ryanmio/legend-class-autonomous-cutter/firmware/legend_cutter/telemetry.cpp

// telemetry.cpp
// WiFi (scan-first: home → any "iPhone" hotspot → blind fallback; no AP) +
// non-blocking in-loop reconnect, plus the HTTP server with the full
// /telemetry JSON and all command endpoints. Wire contract mirrors the PASS'd
// test_29 build 1:1 (key set, key order, routes) — the phone app is firmware-
// agnostic only as long as that holds.

#include "telemetry.h"
#include "config.h"
#include "secrets.h"
#include "ibus.h"
#include "motors.h"
#include "imu.h"
#include "gps.h"
#include "navigation.h"
#include "battery.h"
#include "bilge.h"
#include "sonar.h"
#include "audio.h"
#include "radar.h"
#include "lights.h"
#include "lowvolt.h"
#include "floodalarm.h"
#include "weapons.h"
#include "histlog.h"
#include "flightlog.h"
#include "cmd.h"

#include <WiFi.h>
#include <WebServer.h>
#include <ArduinoJson.h>
#include <esp_system.h>
#include <esp_wifi.h>

// Provided by legend_cutter.ino — current vessel mode label + failsafe ack.
extern const char* vesselModeName();
extern bool        vesselFailsafeAck();

static WebServer    server(HTTP_PORT);
static void         networkTask(void*);    // core-0 task; owns handleClient()/wifiMaintain()
static TaskHandle_t netTaskHandle = NULL;  // for stack high-water queries from the loop console
static String       boatIP;
static uint16_t  cruiseUs  = DEFAULT_CRUISE_US;
static uint32_t  sessionId = 0;     // hardware-random, set once in telemetryBegin()

// WiFi link state, published by networkTask (core 0) ~2 Hz and read cross-core
// by histlogUpdate (core 1). Lock-free, expendable — same discipline as the
// telemetry reads, so the control loop never touches a network function.
static volatile bool   wifiAssocPub = false;
static volatile int8_t wifiRssiPub  = 0;    // dBm when associated, else 0

// millis() of the last app request, written by the core-0 handlers and read
// cross-core by histlog (core 1). Lock-free, expendable — same discipline as
// the WiFi publishes above.
static volatile uint32_t lastClientMs = 0;

// Lazily generated so flightlogBegin() (which runs before telemetryBegin())
// can stamp the boot's session into the flight-file header; telemetryBegin()
// calls this too, so both always see the same value.
uint32_t telemetrySessionId() {
    while (sessionId == 0) sessionId = esp_random();
    return sessionId;
}

uint16_t    telemetryCruiseUs()             { return cruiseUs; }
void        telemetrySetCruiseUs(uint16_t us) { cruiseUs = us; }  // control loop only (cmdApply)
const char* telemetryBoatIP()               { return boatIP.c_str(); }
bool        telemetryWifiAssoc()            { return wifiAssocPub; }
int8_t      telemetryWifiRssiDbm()          { return wifiRssiPub; }
uint32_t    telemetryLastClientMs()         { return lastClientMs; }

// Network task's worst-case-ever free stack (bytes). Queried from the loop's
// serial console; uxTaskGetStackHighWaterMark works cross-task given the handle.
uint32_t    telemetryNetStackFreeBytes() {
    return netTaskHandle ? (uint32_t)(uxTaskGetStackHighWaterMark(netTaskHandle) * sizeof(StackType_t)) : 0;
}

// ── WiFi (scan-first connect + non-blocking maintain, ported from test_29) ──
static String lastSsid;
static String lastPass;
static bool   wifiWasConnected = false;

// Boot-time nav-light signal so the operator can read WiFi state across the
// pool: 1 flash when scanning starts, 2 flashes once connected. Setup-only
// (boat neutral on the bench); leaves the LED off afterward.
static void blinkNav(int times) {
    for (int i = 0; i < times; i++) {
        digitalWrite(PIN_NAV, HIGH); delay(120);
        digitalWrite(PIN_NAV, LOW);  delay(120);
    }
}

// STA-link range/robustness tuning. Telemetry/command only — does NOT touch the
// RC/iBUS control path or the FSM. Split in two: the protocol/bandwidth pins must
// be set on the started driver before associating; the power-save + TX-power
// asserts are re-applied on every (re)connect because association can reset them.
//
// 11b is kept enabled so rate control retains the longest-range basic-rate
// fallback; 20 MHz is pinned for edge robustness. Channel is the AP's to choose
// (a STA follows it), so it's a router-side setting, not a firmware lever.
static void wifiSetStaRadioConfig() {
    esp_wifi_set_protocol(WIFI_IF_STA,
        WIFI_PROTOCOL_11B | WIFI_PROTOCOL_11G | WIFI_PROTOCOL_11N);
    esp_wifi_set_bandwidth(WIFI_IF_STA, WIFI_BW_HT20);
}

static void wifiAssertLinkTuning() {
    WiFi.setSleep(false);            // no Wi-Fi modem sleep → steadier polls at range
    int8_t before = 0, after = 0;
    esp_wifi_get_max_tx_power(&before);
    esp_wifi_set_max_tx_power(84);   // driver max (unit = 0.25 dBm → ~20 dBm)
    esp_wifi_get_max_tx_power(&after);
    Serial.printf("[WiFi] TX power %.2f→%.2f dBm; modem-sleep off\n",
                  before * 0.25f, after * 0.25f);
}

static void wifiConnect() {
    Serial.println();
    Serial.println("[WiFi] Scanning…");
    blinkNav(1);
    WiFi.disconnect(true);
    delay(100);
    WiFi.mode(WIFI_STA);
    wifiSetStaRadioConfig();
    int n = WiFi.scanNetworks();
    Serial.printf("[WiFi] %d networks found\n", n);

    String ssid;
    String pass;
    bool foundHome = false;

    for (int i = 0; i < n; i++) {
        String s = WiFi.SSID(i);
        Serial.printf("  [%d] '%s' RSSI=%d\n", i, s.c_str(), WiFi.RSSI(i));
        if (s == SECRET_HOME_SSID) {
            ssid = s; pass = SECRET_HOME_PASS; foundHome = true;
            Serial.printf("[WiFi] matched home: %s\n", s.c_str());
            break;
        }
    }

    if (!foundHome) {
        for (int i = 0; i < n; i++) {
            String s = WiFi.SSID(i);
            if (s.indexOf("iPhone") >= 0 || s == SECRET_HOTSPOT_SSID) {
                ssid = s; pass = SECRET_HOTSPOT_PASS;
                Serial.printf("[WiFi] matched hotspot: %s\n", s.c_str());
                break;
            }
        }
    }

    if (ssid.length() == 0) {
        ssid = SECRET_HOTSPOT_SSID;
        pass = SECRET_HOTSPOT_PASS;
        Serial.printf("[WiFi] no scan match — blind-connecting: %s\n", ssid.c_str());
    }

    lastSsid = ssid;
    lastPass = pass;
    WiFi.begin(ssid.c_str(), pass.c_str());
    Serial.print("[WiFi] connecting");
    for (int i = 0; i < 40; i++) {       // 20 s
        if (WiFi.status() == WL_CONNECTED) {
            boatIP = WiFi.localIP().toString();
            wifiWasConnected = true;
            wifiAssertLinkTuning();
            Serial.printf(" OK %s\n", boatIP.c_str());
            blinkNav(2);
            return;
        }
        delay(500);
        Serial.print(".");
    }
    Serial.printf(" FAIL (status=%d)\n", WiFi.status());
}

// Non-blocking reconnect, called every loop. On WiFi loss it re-issues
// WiFi.begin() (returns immediately) at most once per 30 s using the boot
// credentials. No scan, no delay — outputs/iBUS/failsafe keep running.
static void wifiMaintain() {
    if (WiFi.status() == WL_CONNECTED) {
        if (!wifiWasConnected) {
            wifiWasConnected = true;
            boatIP = WiFi.localIP().toString();
            wifiAssertLinkTuning();
            Serial.printf("[WiFi] reconnected: %s\n", boatIP.c_str());
        }
        return;
    }
    if (wifiWasConnected) {
        wifiWasConnected = false;
        Serial.println("[WiFi] lost — retrying in background; boat unaffected");
    }
    static uint32_t lastAttemptMs = 0;
    if (millis() - lastAttemptMs >= 30000 && lastSsid.length() > 0) {
        lastAttemptMs = millis();
        WiFi.begin(lastSsid.c_str(), lastPass.c_str());
    }
}

// ── CORS ───────────────────────────────────────────────────────────────────
static void addCORS() {
    server.sendHeader("Access-Control-Allow-Origin",  "*");
    server.sendHeader("Access-Control-Allow-Methods", "GET, POST, OPTIONS");
    server.sendHeader("Access-Control-Allow-Headers", "Content-Type");
}
static void handleOptions() { addCORS(); server.send(204); }

// ── Handlers ───────────────────────────────────────────────────────────────
static void handleStatus() {
    addCORS();
    server.send(200, "application/json",
        String("{\"ok\":true,\"v\":\"") + FIRMWARE_VERSION +
        "\",\"ip\":\"" + boatIP + "\"}");
}

static void handleTelemetry() {
    addCORS();
    lastClientMs = millis();   // app is here; keeps histlog at 1 s (no coarsen)
    StaticJsonDocument<3072> doc;
    doc["v"]            = FIRMWARE_VERSION;
    doc["session_id"]   = sessionId;
    doc["uptime"]       = millis() / 1000;
    doc["heap"]         = ESP.getFreeHeap();
    doc["wifi_assoc"]   = wifiAssocPub;    // live rows are trivially associated;
    doc["rssi"]         = wifiRssiPub;     // rssi is the real-time signal meter
    doc["mode"]         = vesselModeName();
    doc["cruise_us"]    = cruiseUs;
    doc["failsafe_ack"] = vesselFailsafeAck();
    doc["rc_ever_good"] = ibusEverGood();
    doc["rc_age_ms"]    = ibusEverGood() ? (millis() - ibusLastFrameMs()) : 0;
    doc["rudder_us"]    = motorsRudderUs();
    doc["port_us"]      = motorsPortUs();
    doc["stbd_us"]      = motorsStbdUs();   // port_us vs stbd_us = AUTO diff-thrust split
    doc["ch_throttle"]  = ibusChannel(IBUS_IDX_THROTTLE);
    doc["ch_rudder"]    = ibusChannel(IBUS_IDX_RUDDER);
    doc["ch_reverse"]   = ibusChannel(IBUS_IDX_REVERSE);
    doc["ch_mode"]      = ibusChannel(IBUS_IDX_MODE);
    doc["ch_guard"]     = ibusChannel(IBUS_IDX_FAILSAFE_GUARD);
    doc["ch_gun_pan"]   = ibusChannel(IBUS_IDX_GUN_PAN);
    doc["gun_pan_us"]   = weaponsGunPanUs();
    doc["nav_on"]       = lightsState(LED_NAV);
    doc["bridge_on"]    = lightsState(LED_BRIDGE);
    doc["deck_on"]      = lightsState(LED_DECK);
    doc["audio_ok"]     = audioAvailable();
    // Latched probe views (bilge.h) — raw reads can miss sub-second contact.
    doc["bilge_fwd"]        = bilgeFwdWetLatched();
    doc["bilge_mid"]        = bilgeMidWetLatched();
    doc["bilge_rear"]       = bilgeRearWetLatched();
    doc["bilge_fwd_hits"]   = bilgeFwdHits();
    doc["bilge_mid_hits"]   = bilgeMidHits();
    doc["bilge_rear_hits"]  = bilgeRearHits();
    doc["bilge_fwd_duty"]   = bilgeFwdDutyPct();
    doc["bilge_mid_duty"]   = bilgeMidDutyPct();
    doc["bilge_rear_duty"]  = bilgeRearDutyPct();
    doc["pump"]         = bilgePumpOn();
    doc["pump_manual"]  = bilgePumpManual();
    BilgePhase phase    = bilgePumpPhase();
    doc["pump_phase"]   = (phase == BILGE_PHASE_ON)       ? "on"
                        : (phase == BILGE_PHASE_PAUSE)    ? "pause"
                        : (phase == BILGE_PHASE_COOLDOWN) ? "cooldown"
                        : "off";
    if (phase != BILGE_PHASE_OFF) {
        doc["pump_cycle"]    = bilgePumpCycle();
        doc["pump_phase_ms"] = bilgePumpPhaseMs();
    }
    doc["radar_on"]       = radarOn();
    doc["radar_speed"]    = radarSpeed();
    doc["radar_burst_ms"] = radarBurstMs();
    doc["radar_pause_ms"] = radarPauseMs();

    doc["depth_mode"] = (sonarMode() == DEPTH_RUN) ? "run" : "off";
    if (sonarLastDepthM() >= 0.0f) {
        char dbuf[12];
        snprintf(dbuf, sizeof(dbuf), "%.2f", sonarLastDepthM());
        doc["depth_m"] = dbuf;
    }
    if (sonarLastReadMs() > 0) {
        doc["depth_age_ms"]  = millis() - sonarLastReadMs();
        doc["depth_raw_us"]  = sonarLastRawUs();  // diagnostic: 0=timeout, floor band=no bottom return
    }

    char buf[24];
    // `heading` is the boat's best TRUE heading (mag + declination + COG
    // trim) — directly comparable to `course` and `wp_bearing`.
    snprintf(buf, sizeof(buf), "%.1f", imuHeadingTrue()); doc["heading"]     = buf;
    snprintf(buf, sizeof(buf), "%.1f", imuHeadingMag());  doc["heading_mag"] = buf;
    snprintf(buf, sizeof(buf), "%.1f", imuCogTrim());     doc["cog_trim"]    = buf;
    if (batteryAvailable()) {
        snprintf(buf, sizeof(buf), "%.2f", batteryVolts()); doc["batt_v"] = buf;
        // batt_a dropped: shunt failed, reads a constant 0. Voltage still good.
    }
    doc["low_volt_alarm"] = lowVoltActive();
    doc["flood_alarm"]    = floodAlarmActive();

    // Flight-log health, so the live screen can show mission logging died
    // instead of leaving it to be discovered at import time.
    doc["flight_log"]     = flightlogActiveName();   // "" = disabled at boot
    doc["flight_full"]    = flightlogFull();
    doc["flight_dropped"] = flightlogDropped();
    doc["flight_free_kb"] = flightlogFreeBytesPub() / 1024;

    // Position
    doc["gps_fix"] = gpsValid();
    if (gpsValid()) {
        snprintf(buf, sizeof(buf), "%.6f", gpsLat()); doc["lat"] = buf;
        snprintf(buf, sizeof(buf), "%.6f", gpsLon()); doc["lon"] = buf;
    }
    doc["sats"] = (int)gpsSats();
    if (gpsSpeedValid())  { snprintf(buf, sizeof(buf), "%.1f", gpsSpeedKnots()); doc["speed_kts"] = buf; }
    if (gpsCourseValid()) { snprintf(buf, sizeof(buf), "%.1f", gpsCourseDeg());  doc["course"]    = buf; }

    // Waypoint / mission. wp_* report the active leg; mission_* give sequencer
    // state. captured means "mission complete" (a 1-point mission → single-WP
    // capture, unchanged). wp_idx is 0-based.
    doc["mission_active"] = navMissionActive();
    doc["wp_count"]       = navWpCount();
    doc["wp_idx"]         = navWpIdx();
    doc["wp_set"]   = navWpSet();
    doc["captured"] = navCaptured();
    doc["approach_lock"] = navApproachLocked();
    CapturedBy cb = navCapturedBy();
    doc["captured_by"] = (cb == CAPTURED_BY_DISTANCE) ? "distance"
                       : (cb == CAPTURED_BY_CROSSING) ? "crossing"
                       : "none";
    if (navWpSet()) {
        snprintf(buf, sizeof(buf), "%.6f", navWpLat()); doc["wp_lat"] = buf;
        snprintf(buf, sizeof(buf), "%.6f", navWpLon()); doc["wp_lon"] = buf;
        if (gpsValid()) {
            snprintf(buf, sizeof(buf), "%.1f", navWpDistM());   doc["wp_dist_m"]  = buf;
            snprintf(buf, sizeof(buf), "%.1f", navWpBearing()); doc["wp_bearing"] = buf;
        }
        if (navStartValid()) {
            snprintf(buf, sizeof(buf), "%.6f", navStartLat()); doc["wp_start_lat"] = buf;
            snprintf(buf, sizeof(buf), "%.6f", navStartLon()); doc["wp_start_lon"] = buf;
        }
    }

    // PID (current live values)
    snprintf(buf, sizeof(buf), "%.2f", pidKp()); doc["pid_kp"] = buf;
    snprintf(buf, sizeof(buf), "%.2f", pidKd()); doc["pid_kd"] = buf;
    snprintf(buf, sizeof(buf), "%.2f", motorsAutoDiffGain()); doc["diff_gain"] = buf;

    // ── Mag calibration / health ─────────────────────────────────────────
    doc["mag_cal_state"]    = imuMagCalStateName();
    doc["mag_cal_progress"] = imuMagCalProgressPct();
    doc["mag_calibrated"]   = imuMagCalibrated();
    doc["mag_cal_ts"]       = imuMagCalTs();
    doc["mag_from_nvs"]     = imuMagFromNVS();
    if (imuMagCalCollecting()) doc["mag_cal_mask"] = imuMagCalMask();
    if (imuMagCalFailed())     doc["mag_cal_fail"] = imuMagCalFailReason();
    doc["mag_cal_quality"] = imuMagCalQualityName();
    if (imuMagCalQualityKnown()) {
        snprintf(buf, sizeof(buf), "%.1f", imuMagCalRadiusUT()); doc["mag_cal_radius_uT"] = buf;
        snprintf(buf, sizeof(buf), "%.0f", imuMagCalCircPct());  doc["mag_cal_circ_pct"]  = buf;
    }
    snprintf(buf, sizeof(buf), "%.2f", imuMagOffX());       doc["mag_off_x"]       = buf;
    snprintf(buf, sizeof(buf), "%.2f", imuMagOffY());       doc["mag_off_y"]       = buf;
    snprintf(buf, sizeof(buf), "%.2f", imuMagOffZ());       doc["mag_off_z"]       = buf;
    snprintf(buf, sizeof(buf), "%.2f", imuMagBaselineUT()); doc["mag_baseline_uT"] = buf;
    snprintf(buf, sizeof(buf), "%.2f", imuLiveMagUT());     doc["mag_uT"]          = buf;

    // A payload that fills (or overflows) out[] leaves ArduinoJson no room to
    // null-terminate it; server.send() would then read out[] as a C-string
    // past its end. Hard-guard rather than ever send that. static (not stack):
    // handlers run only on the single network task, so it's non-reentrant, and
    // keeping 3 KB off the task stack leaves NET_TASK_STACK more headroom, not less.
    static char out[3072];
    // The doc pool is heap-elastic: a failed allocation drops members silently and
    // measureJson() then reports the TRUNCATED length, which would pass the size
    // guard below and ship a 200 with fields missing or null. Size cannot see this
    // (truncation makes the payload smaller), so check the pool itself.
    if (doc.overflowed()) {
        Serial.println("[telemetry] ERROR json doc overflowed (heap), dropping frame");
        server.send(500, "application/json", "{\"ok\":false,\"err\":\"telemetry truncated\"}");
        return;
    }
    size_t jsonLen = measureJson(doc);
    if (jsonLen >= sizeof(out) - 1) {
        Serial.printf("[telemetry] ERROR json=%u exceeds %u buffer, dropping frame\n",
                      (unsigned)jsonLen, (unsigned)sizeof(out));
        server.send(500, "application/json", "{\"ok\":false,\"err\":\"telemetry too large\"}");
        return;
    }
    if (jsonLen > 2800) Serial.printf("[telemetry] WARN json=%u bytes near 3072 buffer\n", (unsigned)jsonLen);
    serializeJson(doc, out);
    server.send(200, "application/json", out);
}

static void handleCruise() {
    addCORS();
    if (server.method() == HTTP_OPTIONS) { server.send(204); return; }
    if (server.method() != HTTP_POST)    { server.send(405, "text/plain", "Method Not Allowed"); return; }

    StaticJsonDocument<128> req;
    if (deserializeJson(req, server.arg("plain"))) { server.send(400, "text/plain", "Bad JSON"); return; }

    uint16_t newUs = 0;
    if (req.containsKey("us")) {
        int us = req["us"].as<int>();
        if (us < NEUTRAL_US || us > MAX_FWD_US) {
            char err[80];
            snprintf(err, sizeof(err),
                "{\"ok\":false,\"err\":\"us out of [%u..%u]\"}", NEUTRAL_US, MAX_FWD_US);
            server.send(400, "application/json", err);
            return;
        }
        newUs = (uint16_t)us;
    } else if (req.containsKey("pct")) {
        float pct = req["pct"].as<float>();
        if (pct < 0.0f)   pct = 0.0f;
        if (pct > 100.0f) pct = 100.0f;
        newUs = (uint16_t)(NEUTRAL_US + (MAX_FWD_US - NEUTRAL_US) * (pct / 100.0f));
    } else {
        server.send(400, "text/plain", "Need 'us' or 'pct'");
        return;
    }

    Command c = {};
    c.type     = CMD_CRUISE;
    c.cruiseUs = newUs;
    if (!cmdEnqueue(c)) { server.send(503, "application/json", "{\"ok\":false,\"err\":\"busy\"}"); return; }

    StaticJsonDocument<128> resp;
    resp["ok"]        = true;
    resp["cruise_us"] = newUs;                 // requested value; applied within one control cycle
    resp["cap"]       = AUTO_CRUISE_CAP_US;
    char out[128];
    serializeJson(resp, out);
    server.send(200, "application/json", out);
}

static void handleWaypoint() {
    addCORS();
    if (server.method() == HTTP_OPTIONS) { server.send(204); return; }
    if (server.method() != HTTP_POST)    { server.send(405, "text/plain", "Method Not Allowed"); return; }

    StaticJsonDocument<128> req;
    if (deserializeJson(req, server.arg("plain"))) { server.send(400, "text/plain", "Bad JSON"); return; }

    // {"lat":null,"lon":null} → clear waypoint and reset capture latch.
    if (req["lat"].isNull() || req["lon"].isNull()) {
        Command c = {}; c.type = CMD_WAYPOINT_CLEAR;
        if (!cmdEnqueue(c)) { server.send(503, "application/json", "{\"ok\":false,\"err\":\"busy\"}"); return; }
        server.send(200, "application/json", "{\"ok\":true,\"cleared\":true}");
        return;
    }
    // Numeric + bounds (mirrors handleMission so the two set-paths don't drift;
    // null is the clear signal handled above).
    if (!req["lat"].is<float>() || !req["lon"].is<float>()) {
        server.send(400, "text/plain", "Need numeric lat and lon");
        return;
    }
    float lat = req["lat"].as<float>();
    float lon = req["lon"].as<float>();
    if (lat < -90.0f || lat > 90.0f || lon < -180.0f || lon > 180.0f) {
        server.send(400, "application/json", "{\"ok\":false,\"err\":\"lat/lon out of range\"}");
        return;
    }
    float d   = 0.0f;
    // Validate (read-only) here; the control loop performs the actual set.
    if (!navWaypointInRange(lat, lon, &d)) {
        char err[96];
        snprintf(err, sizeof(err),
            "{\"ok\":false,\"err\":\"waypoint %.0f m away (max %.0f m)\"}", d, MAX_WP_DIST_M);
        server.send(400, "application/json", err);
        return;
    }
    Command c = {}; c.type = CMD_WAYPOINT_SET; c.lat = lat; c.lon = lon;
    if (!cmdEnqueue(c)) { server.send(503, "application/json", "{\"ok\":false,\"err\":\"busy\"}"); return; }

    StaticJsonDocument<128> resp;
    resp["ok"]  = true;
    resp["lat"] = lat;
    resp["lon"] = lon;
    char out[128];
    serializeJson(resp, out);
    server.send(200, "application/json", out);
}

// POST /mission — ordered multi-waypoint route. Body is a TOP-LEVEL JSON array
// [{"lat":..,"lon":..}, …] (test_28's proven shape). Chain-validated (per-leg),
// staged, then committed on the control loop via CMD_MISSION_COMMIT. A single
// waypoint still goes through /waypoint; this is the multi-leg path.
static void handleMission() {
    addCORS();
    if (server.method() == HTTP_OPTIONS) { server.send(204); return; }
    if (server.method() != HTTP_POST)    { server.send(405, "text/plain", "Method Not Allowed"); return; }

    // Up to MAX_WAYPOINTS * {lat,lon} + framing — ~2 KB worst case at 32 points.
    DynamicJsonDocument req(3072);
    if (deserializeJson(req, server.arg("plain"))) { server.send(400, "text/plain", "Bad JSON"); return; }
    JsonArray arr = req.as<JsonArray>();
    if (arr.isNull())    { server.send(400, "text/plain", "Body must be an array of {lat,lon}"); return; }
    if (arr.size() == 0) { server.send(400, "application/json", "{\"ok\":false,\"err\":\"empty mission\"}"); return; }
    if (arr.size() > MAX_WAYPOINTS) {
        char e[72];
        snprintf(e, sizeof(e), "{\"ok\":false,\"err\":\"too many waypoints (max %u)\"}", MAX_WAYPOINTS);
        server.send(400, "application/json", e);
        return;
    }

    Waypoint pts[MAX_WAYPOINTS];
    uint8_t  n = 0;
    for (JsonObject wp : arr) {
        // Require numeric lat/lon. is<float>() is true for JSON ints/floats and
        // false for missing, null, or string — this closes the gap where a null
        // or typo'd value coerces via .as<float>() to 0.0 (an in-range (0,0)
        // Gulf-of-Guinea waypoint that would slip past the range check).
        if (!wp["lat"].is<float>() || !wp["lon"].is<float>()) {
            server.send(400, "text/plain", "Each waypoint needs numeric lat and lon");
            return;
        }
        float la = wp["lat"].as<float>();
        float lo = wp["lon"].as<float>();
        if (la < -90.0f || la > 90.0f || lo < -180.0f || lo > 180.0f) {
            server.send(400, "application/json", "{\"ok\":false,\"err\":\"waypoint lat/lon out of range\"}");
            return;
        }
        pts[n].lat = la;
        pts[n].lon = lo;
        n++;
    }

    // Per-leg (chained) fat-finger guard — a pre-planned route's later points are
    // > MAX_WP_DIST_M from the launch spot, so boat→each would wrongly reject them.
    uint8_t badLeg = 0;
    float   badDist = 0.0f;
    if (!navMissionInRange(pts, n, &badLeg, &badDist)) {
        char e[128];
        // Human message is 1-based to match the map markers (#1..N); the bad_leg
        // field stays 0-based so the app can index the draft array directly.
        snprintf(e, sizeof(e),
            "{\"ok\":false,\"err\":\"waypoint #%u too far: %.0f m (max %.0f m)\",\"bad_leg\":%u}",
            (unsigned)(badLeg + 1), badDist, MAX_WP_DIST_M, badLeg);
        server.send(400, "application/json", e);
        return;
    }

    if (!navStageMission(pts, n)) {
        server.send(503, "application/json", "{\"ok\":false,\"err\":\"busy\"}");
        return;
    }
    Command c = {}; c.type = CMD_MISSION_COMMIT;
    if (!cmdEnqueue(c)) {
        navAbortStage();   // control loop will never commit — don't wedge future missions
        server.send(503, "application/json", "{\"ok\":false,\"err\":\"busy\"}");
        return;
    }

    char out[64];
    snprintf(out, sizeof(out), "{\"ok\":true,\"wp_count\":%u}", n);
    server.send(200, "application/json", out);
}

// POST /mission/clear — clear the whole mission (same control-loop path as
// clearing a single waypoint).
static void handleMissionClear() {
    addCORS();
    if (server.method() == HTTP_OPTIONS) { server.send(204); return; }
    if (server.method() != HTTP_POST)    { server.send(405, "text/plain", "Method Not Allowed"); return; }
    Command c = {}; c.type = CMD_WAYPOINT_CLEAR;
    if (!cmdEnqueue(c)) { server.send(503, "application/json", "{\"ok\":false,\"err\":\"busy\"}"); return; }
    server.send(200, "application/json", "{\"ok\":true,\"cleared\":true}");
}

// GET /mission — the loaded route, so the app can rehydrate the planned polyline
// after a relaunch mid-mission. Unsynchronized cross-core read of route[]/wpCount
// (same lock-free convention as the wp_* fields in /telemetry). A torn read would
// require this GET to land within the microseconds of a startMission() commit on
// the control core — vanishingly unlikely with a single operator, and the app
// re-fetches on the next mount; not re-polled, so it does NOT self-correct within
// a session. Acceptable given the odds; noted rather than locked.
static void handleMissionGet() {
    addCORS();
    DynamicJsonDocument doc(3072);
    doc["mission_active"] = navMissionActive();
    doc["wp_count"]       = navWpCount();
    doc["wp_idx"]         = navWpIdx();
    JsonArray wps = doc.createNestedArray("waypoints");
    float lat, lon;
    char b[16];
    for (uint8_t i = 0; navWpAt(i, &lat, &lon); i++) {
        JsonObject o = wps.createNestedObject();
        snprintf(b, sizeof(b), "%.6f", lat); o["lat"] = b;
        snprintf(b, sizeof(b), "%.6f", lon); o["lon"] = b;
    }
    // Same heap-elastic pool hazard as /telemetry: a truncated route would draw a
    // polyline that silently disagrees with the mission the boat is flying, and
    // this GET is not re-polled, so it would not self-correct within a session.
    if (doc.overflowed()) {
        Serial.println("[mission] ERROR json doc overflowed (heap), refusing truncated route");
        server.send(500, "application/json", "{\"ok\":false,\"err\":\"mission truncated\"}");
        return;
    }
    String out;
    serializeJson(doc, out);
    server.send(200, "application/json", out.c_str());
}

static void handlePid() {
    addCORS();
    if (server.method() == HTTP_OPTIONS) { server.send(204); return; }
    if (server.method() != HTTP_POST)    { server.send(405, "text/plain", "Method Not Allowed"); return; }

    StaticJsonDocument<128> req;
    if (deserializeJson(req, server.arg("plain"))) { server.send(400, "text/plain", "Bad JSON"); return; }

    float kp = pidKp();
    float kd = pidKd();
    if (req.containsKey("kp")) {
        kp = req["kp"].as<float>();
        if (kp < 0.0f || kp > 20.0f) {
            server.send(400, "application/json", "{\"ok\":false,\"err\":\"kp out of [0..20]\"}");
            return;
        }
    }
    if (req.containsKey("kd")) {
        kd = req["kd"].as<float>();
        if (kd < 0.0f || kd > 30.0f) {
            server.send(400, "application/json", "{\"ok\":false,\"err\":\"kd out of [0..30]\"}");
            return;
        }
    }
    float diffGain = motorsAutoDiffGain();
    if (req.containsKey("diff_gain")) {
        diffGain = req["diff_gain"].as<float>();
        if (diffGain < 0.0f || diffGain > 2.0f) {
            server.send(400, "application/json", "{\"ok\":false,\"err\":\"diff_gain out of [0..2]\"}");
            return;
        }
    }
    Command c = {};
    c.type     = CMD_PID;
    c.kp       = kp;     // resolved against current above; loop applies all three
    c.kd       = kd;
    c.diffGain = diffGain;
    if (!cmdEnqueue(c)) { server.send(503, "application/json", "{\"ok\":false,\"err\":\"busy\"}"); return; }

    StaticJsonDocument<128> resp;
    resp["ok"] = true;
    resp["kp"] = kp;                           // requested values; applied within one control cycle
    resp["kd"] = kd;
    resp["diff_gain"] = diffGain;
    char out[128];
    serializeJson(resp, out);
    server.send(200, "application/json", out);
}

static void handleCalibrateMagStart() {
    addCORS();
    if (server.method() == HTTP_OPTIONS) { server.send(204); return; }
    if (server.method() != HTTP_POST)    { server.send(405, "text/plain", "Method Not Allowed"); return; }

    if (imuMagCalCollecting()) {
        server.send(200, "application/json",
            "{\"ok\":true,\"state\":\"collecting\",\"note\":\"already running\"}");
        return;
    }
    Command c = {}; c.type = CMD_MAGCAL_START;
    if (!cmdEnqueue(c)) { server.send(503, "application/json", "{\"ok\":false,\"err\":\"busy\"}"); return; }
    server.send(200, "application/json", "{\"ok\":true,\"state\":\"collecting\"}");
}

static void handleCalibrateMagAbort() {
    addCORS();
    if (server.method() == HTTP_OPTIONS) { server.send(204); return; }
    if (server.method() != HTTP_POST)    { server.send(405, "text/plain", "Method Not Allowed"); return; }

    if (!imuMagCalCollecting()) {
        server.send(200, "application/json",
            "{\"ok\":true,\"state\":\"idle\",\"note\":\"not collecting\"}");
        return;
    }
    Command c = {}; c.type = CMD_MAGCAL_ABORT;
    if (!cmdEnqueue(c)) { server.send(503, "application/json", "{\"ok\":false,\"err\":\"busy\"}"); return; }
    server.send(200, "application/json", "{\"ok\":true,\"state\":\"idle\"}");
}

static void handleLed() {
    addCORS();
    if (server.method() == HTTP_OPTIONS) { server.send(204); return; }
    if (server.method() != HTTP_POST)    { server.send(405, "text/plain", "Method Not Allowed"); return; }

    StaticJsonDocument<128> req;
    if (deserializeJson(req, server.arg("plain"))) { server.send(400, "text/plain", "Bad JSON"); return; }

    const char* light = req["light"] | "";
    bool        on    = req["state"]  | false;
    LedId id;
    if      (!strcmp(light, "nav"))    id = LED_NAV;
    else if (!strcmp(light, "bridge")) id = LED_BRIDGE;
    else if (!strcmp(light, "deck"))   id = LED_DECK;
    else { server.send(400, "text/plain", "Unknown light"); return; }

    Command c = {}; c.type = CMD_LED; c.ledId = (uint8_t)id; c.ledOn = on;
    if (!cmdEnqueue(c)) { server.send(503, "application/json", "{\"ok\":false,\"err\":\"busy\"}"); return; }
    server.send(200, "application/json", "{\"ok\":true}");
}

static void handleAudio() {
    addCORS();
    if (server.method() == HTTP_OPTIONS) { server.send(204); return; }
    if (server.method() != HTTP_POST)    { server.send(405, "text/plain", "Method Not Allowed"); return; }

    if (!audioAvailable()) {
        server.send(503, "application/json", "{\"ok\":false,\"err\":\"DF1201S not initialised\"}");
        return;
    }

    StaticJsonDocument<96> req;
    if (deserializeJson(req, server.arg("plain"))) { server.send(400, "text/plain", "Bad JSON"); return; }
    const char* sound = req["sound"] | "";

    AudioClip clip;
    if      (!strcmp(sound, "horn"))  clip = AUDIO_HORN;
    else if (!strcmp(sound, "gun"))   clip = AUDIO_GUN;
    else if (!strcmp(sound, "board")) clip = AUDIO_BOARD;
    else {
        server.send(400, "application/json", "{\"ok\":false,\"err\":\"unknown sound\"}");
        return;
    }
    audioPlay(clip);

    StaticJsonDocument<96> resp;
    resp["ok"]    = true;
    resp["sound"] = sound;
    char out[96];
    serializeJson(resp, out);
    server.send(200, "application/json", out);
}

// Bench test path for the low-voltage alarm. Forces the REAL latch (via the cmd
// queue → lowVoltForceLatch on core 1), so it exercises the actual annunciation:
// repeating horn, nav-light double-blink, and the low_volt_alarm telemetry flag.
// On the bench (USB, HV bus ≈ 0 V, below LOWER) the latch will not self-clear, so
// it annunciates until a power cycle — same as any real latch.
static void handleTestLowVolt() {
    addCORS();
    if (server.method() == HTTP_OPTIONS) { server.send(204); return; }
    if (server.method() != HTTP_POST)    { server.send(405, "text/plain", "Method Not Allowed"); return; }
    Command c = {}; c.type = CMD_LOWVOLT_TEST;
    if (!cmdEnqueue(c)) { server.send(503, "application/json", "{\"ok\":false,\"err\":\"busy\"}"); return; }
    server.send(200, "application/json", "{\"ok\":true,\"forced\":\"low_volt_alarm\"}");
}

static void handleBilge() {
    addCORS();
    if (server.method() == HTTP_OPTIONS) { server.send(204); return; }
    if (server.method() != HTTP_POST)    { server.send(405, "text/plain", "Method Not Allowed"); return; }

    StaticJsonDocument<128> req;
    if (deserializeJson(req, server.arg("plain"))) { server.send(400, "text/plain", "Bad JSON"); return; }

    bool on = req["on"] | false;
    Command c = {}; c.type = CMD_BILGE; c.bilgeOn = on;
    if (!cmdEnqueue(c)) { server.send(503, "application/json", "{\"ok\":false,\"err\":\"busy\"}"); return; }

    StaticJsonDocument<128> resp;
    resp["ok"]          = true;
    resp["pump_manual"] = on;                  // requested value; applied within one control cycle
    char out[128];
    serializeJson(resp, out);
    server.send(200, "application/json", out);
}

static void handleRadar() {
    addCORS();
    if (server.method() == HTTP_OPTIONS) { server.send(204); return; }
    if (server.method() != HTTP_POST)    { server.send(405, "text/plain", "Method Not Allowed"); return; }

    StaticJsonDocument<192> req;
    if (deserializeJson(req, server.arg("plain"))) { server.send(400, "text/plain", "Bad JSON"); return; }

    // All fields optional — apply only those present.
    bool     on = radarOn();
    uint8_t  s  = radarSpeed();
    uint32_t b  = radarBurstMs();
    uint32_t p  = radarPauseMs();

    if (req.containsKey("on")) on = req["on"].as<bool>();
    if (req.containsKey("speed")) {
        int v = req["speed"].as<int>();
        if (v < 0)   v = 0;
        if (v > 100) v = 100;
        s = (uint8_t)v;
    }
    if (req.containsKey("burst_ms")) b = (uint32_t)req["burst_ms"].as<long>();
    if (req.containsKey("pause_ms")) p = (uint32_t)req["pause_ms"].as<long>();

    Command c = {};
    c.type = CMD_RADAR;
    c.radarOn = on; c.radarSpeed = s; c.radarBurstMs = b; c.radarPauseMs = p;
    if (!cmdEnqueue(c)) { server.send(503, "application/json", "{\"ok\":false,\"err\":\"busy\"}"); return; }

    StaticJsonDocument<160> resp;
    resp["ok"]       = true;                   // resolved values; applied within one control cycle
    resp["on"]       = on;
    resp["speed"]    = s;
    resp["burst_ms"] = b;
    resp["pause_ms"] = p;
    char out[160];
    serializeJson(resp, out);
    server.send(200, "application/json", out);
}

static void handleDepth() {
    addCORS();
    if (server.method() == HTTP_OPTIONS) { server.send(204); return; }
    if (server.method() != HTTP_POST)    { server.send(405, "text/plain", "Method Not Allowed"); return; }

    StaticJsonDocument<96> req;
    if (deserializeJson(req, server.arg("plain"))) { server.send(400, "text/plain", "Bad JSON"); return; }

    const char* m = req["mode"] | "";
    Command c = {};
    const char* respMode;
    if      (!strcmp(m, "stop")) { c.type = CMD_DEPTH_MODE; c.depthRun = false; respMode = "off"; }
    else if (!strcmp(m, "run"))  { c.type = CMD_DEPTH_MODE; c.depthRun = true;  respMode = "run"; }
    else if (!strcmp(m, "check")){ c.type = CMD_DEPTH_PING; respMode = (sonarMode() == DEPTH_RUN) ? "run" : "off"; }
    else {
        server.send(400, "application/json", "{\"ok\":false,\"err\":\"mode must be stop|check|run\"}");
        return;
    }
    if (!cmdEnqueue(c)) { server.send(503, "application/json", "{\"ok\":false,\"err\":\"busy\"}"); return; }

    StaticJsonDocument<128> resp;
    resp["ok"]   = true;
    resp["mode"] = respMode;
    if (sonarLastDepthM() >= 0.0f) {
        char dbuf[12];
        snprintf(dbuf, sizeof(dbuf), "%.2f", sonarLastDepthM());
        resp["depth_m"] = dbuf;
    }
    char out[128];
    serializeJson(resp, out);
    server.send(200, "application/json", out);
}

// ── /history (store-and-sync gap backfill) ──────────────────────────────────
// GET /history?since_ms=<uptimeMs> → records with uptimeMs > since_ms, oldest
// first, capped at HISTLOG_PAGE_MAX. Response:
//   {"session_id":N,"more":bool,"records":[ {…compact telemetry…}, … ]}
// The app pages by re-requesting with since_ms = the last record's uptime_ms,
// and finalizes the flight (rather than backfilling) when session_id changes.
// Record keys + value types mirror /telemetry so the app slots them straight
// into the same flight log; invalid fields are omitted, exactly as live.
static void appendHistRecord(String& out, const HistRecord* r) {
    char buf[320];
    uint8_t modeCode = r->mode & HIST_MODE_MASK;
    const char* modeStr = (modeCode == 1) ? "MANUAL"
                        : (modeCode == 2) ? "AUTO"
                        : (modeCode == 3) ? "FAILSAFE" : "IDLE";
    bool fix = r->flags & HIST_F_GPS_FIX;
    snprintf(buf, sizeof(buf),
        "{\"seq\":%lu,\"uptime_ms\":%lu,\"mode\":\"%s\","
        "\"port_us\":%d,\"rudder_us\":%d,\"heading\":\"%.1f\","
        "\"gps_fix\":%s,\"sats\":%u",
        (unsigned long)r->seq, (unsigned long)r->uptimeMs, modeStr,
        r->escUs, r->rudderUs, r->heading10 / 10.0f,
        fix ? "true" : "false", r->sats);
    out += buf;

    if (fix) {
        snprintf(buf, sizeof(buf), ",\"lat\":\"%.6f\",\"lon\":\"%.6f\"",
                 r->lat1e7 / 1e7, r->lon1e7 / 1e7);
        out += buf;
    }
    if (r->speedKts100 != INT16_MIN) {
        snprintf(buf, sizeof(buf), ",\"speed_kts\":\"%.1f\"", r->speedKts100 / 100.0f); out += buf;
    }
    if (r->course10 != INT16_MIN) {
        snprintf(buf, sizeof(buf), ",\"course\":\"%.1f\"", r->course10 / 10.0f); out += buf;
    }
    if (r->battCv != INT16_MIN) {
        snprintf(buf, sizeof(buf), ",\"batt_v\":\"%.2f\"", r->battCv / 100.0f);
        out += buf;
    }
    if (r->depthCm >= 0) {
        snprintf(buf, sizeof(buf), ",\"depth_m\":\"%.2f\"", r->depthCm / 100.0f); out += buf;
    }
    snprintf(buf, sizeof(buf), ",\"wp_set\":%s,\"captured\":%s",
             (r->flags & HIST_F_WP_SET)  ? "true" : "false",
             (r->flags & HIST_F_CAPTURED) ? "true" : "false");
    out += buf;
    if (r->flags & HIST_F_WP_SET) {
        // Same field names/format as live /telemetry, so backfilled rows drop
        // straight into the same CSV columns → gapless multi-waypoint playback.
        snprintf(buf, sizeof(buf),
                 ",\"wp_idx\":%u,\"wp_count\":%u,\"wp_lat\":\"%.6f\",\"wp_lon\":\"%.6f\"",
                 r->wpIdx, r->wpCount, r->wpLat1e7 / 1e7, r->wpLon1e7 / 1e7);
        out += buf;
    }
    if (r->wpDist10 >= 0) {
        snprintf(buf, sizeof(buf), ",\"wp_dist_m\":\"%.1f\"", r->wpDist10 / 10.0f); out += buf;
    }
    // Link state at capture — the whole point of the store-and-sync instrument:
    // a backfilled gap now shows whether the boat was still on the hotspot.
    snprintf(buf, sizeof(buf), ",\"wifi_assoc\":%s,\"rssi\":%d",
             (r->flags & HIST_F_WIFI_ASSOC) ? "true" : "false", (int)r->rssiDbm);
    out += buf;
    snprintf(buf, sizeof(buf),
             ",\"pump\":%s,\"bilge_fwd\":%s,\"bilge_mid\":%s,\"bilge_rear\":%s,\"failsafe_ack\":%s}",
             (r->flags & HIST_F_PUMP)              ? "true" : "false",
             (r->flags & HIST_F_BILGE_FWD)         ? "true" : "false",
             (r->flags & HIST_F_BILGE_MID)         ? "true" : "false",
             (r->mode  & HIST_MODE_F_BILGE_REAR)   ? "true" : "false",
             (r->flags & HIST_F_FAILSAFE_ACK)      ? "true" : "false");
    out += buf;
}

// One /history page served from the active flight file instead of the RAM
// ring — the deep-serve path for dropouts longer than the ring window. Same
// response shape, same cursor contract, live sessionId (same boot by
// construction). `more` is constant true: this path only runs when the ring
// holds records newer than anything the file can emit (the file trails live
// capture by up to one flush window), so there is always a next page.
static void serveHistoryPageFromFlash(uint32_t since) {
    server.setContentLength(CONTENT_LENGTH_UNKNOWN);
    server.send(200, "application/json", "");
    char head[80];
    snprintf(head, sizeof(head), "{\"session_id\":%lu,\"more\":true,\"records\":[",
             (unsigned long)sessionId);
    server.sendContent(head);

    String recsOut;
    recsOut.reserve(2048);
    HistRecord chunk[10];
    uint16_t emitted = 0;
    uint32_t cursor  = since;
    int32_t  got     = flightlogRead(flightlogActiveName(), cursor, chunk, 10, NULL, NULL);
    while (got > 0 && emitted < HISTLOG_PAGE_MAX) {
        for (int32_t i = 0; i < got && emitted < HISTLOG_PAGE_MAX; i++) {
            if (emitted > 0) recsOut += ',';
            appendHistRecord(recsOut, &chunk[i]);
            cursor = chunk[i].uptimeMs;
            emitted++;
            if (recsOut.length() > 1536) { server.sendContent(recsOut); recsOut = ""; }
        }
        if (emitted < HISTLOG_PAGE_MAX) {
            got = flightlogRead(flightlogActiveName(), cursor, chunk, 10, NULL, NULL);
        }
    }
    if (recsOut.length()) server.sendContent(recsOut);
    server.sendContent("]}");
    server.sendContent("");
}

static void handleHistory() {
    addCORS();
    lastClientMs = millis();   // app is back; resets histlog cadence to 1 s

    // Backstop for the "no /history reader during the one-time coarsen" invariant.
    // The coarsen runs on core 1 only after the app has been gone >20 min, so a
    // reader is not normally present; if one lands in that µs window, serve an
    // empty page — the app's backfill loop retries and gets the clean view next.
    if (histlogCoarsening()) {
        server.setContentLength(CONTENT_LENGTH_UNKNOWN);
        server.send(200, "application/json", "");
        char busy[80];
        snprintf(busy, sizeof(busy), "{\"session_id\":%lu,\"more\":false,\"records\":[]}",
                 (unsigned long)sessionId);
        server.sendContent(busy);
        server.sendContent("");
        return;
    }

    uint32_t since = 0;
    if (server.hasArg("since_ms")) since = strtoul(server.arg("since_ms").c_str(), NULL, 10);

    // Deep-serve: a cursor older than the ring's oldest record means the gap
    // outran the RAM window. The active flight file holds the full 1 s record
    // back to boot, so serve this page from flash; the ring takes over once
    // the cursor reaches its window, and overlap seconds dedup app-side. The
    // probe guards the flightlog-stopped case (file may end before the ring
    // begins) — then the ring serves what it has, exactly as before.
    // One window snapshot for the whole pass — see HistView in histlog.h.
    HistView view = histlogView();

    if (flightlogEnabled()) {
        const HistRecord* ringOldest = histlogViewAt(view, 0);
        if (ringOldest && since < ringOldest->uptimeMs) {
            HistRecord probe;
            if (flightlogRead(flightlogActiveName(), since, &probe, 1, NULL, NULL) == 1
                && probe.uptimeMs < ringOldest->uptimeMs) {
                serveHistoryPageFromFlash(since);
                return;
            }
        }
    }

    // Chunked send so we never build the whole page in one big buffer.
    server.setContentLength(CONTENT_LENGTH_UNKNOWN);
    server.send(200, "application/json", "");

    char head[80];
    snprintf(head, sizeof(head), "{\"session_id\":%lu,\"more\":", (unsigned long)sessionId);

    uint16_t n = view.count;
    uint16_t sent = 0;
    bool     more = false;
    String   recsOut;                 // accumulates a few records, flushed in batches
    recsOut.reserve(2048);

    // Decide `more` up front so it can go in the header chunk: count how many
    // records qualify; if that exceeds the page cap, there's a next page.
    for (uint16_t i = 0; i < n; i++) {
        const HistRecord* r = histlogViewAt(view, i);
        if (r && r->uptimeMs > since) {
            if (sent >= HISTLOG_PAGE_MAX) { more = true; break; }
            sent++;
        }
    }

    server.sendContent(head);
    server.sendContent(more ? "true,\"records\":[" : "false,\"records\":[");

    uint16_t emitted    = 0;
    uint32_t lastUptime = since;
    for (uint16_t i = 0; i < n && emitted < HISTLOG_PAGE_MAX; i++) {
        const HistRecord* r = histlogViewAt(view, i);
        // Strictly increasing: the producer can overwrite the view's oldest
        // slot mid-pass, so a record may read back out of order. Skipping it
        // keeps the app's cursor monotonic; the next page picks it up.
        if (!r || r->uptimeMs <= lastUptime) continue;
        lastUptime = r->uptimeMs;
        if (emitted > 0) recsOut += ',';
        appendHistRecord(recsOut, r);
        emitted++;
        if (recsOut.length() > 1536) { server.sendContent(recsOut); recsOut = ""; }
    }
    if (recsOut.length()) server.sendContent(recsOut);
    server.sendContent("]}");
    server.sendContent("");           // terminate chunked response
}

// ── /flights, /flight, /flight/delete (full-mission flash log) ──────────────
// GET /flights → inventory of stored flight files plus flightlog health. After
// a reboot the app uses this to find missions from previous boots (crash /
// field power-off) and imports them via GET /flight.
static void handleFlights() {
    addCORS();
    FlightInfo fi[FLIGHTLOG_MAX_FILES];
    uint8_t n = flightlogList(fi, FLIGHTLOG_MAX_FILES);
    String out;
    out.reserve(512 + (size_t)n * 96);
    char buf[160];
    snprintf(buf, sizeof(buf),
             "{\"enabled\":%s,\"full\":%s,\"active\":\"%s\",\"free_bytes\":%lu,\"dropped\":%lu,\"files\":[",
             flightlogEnabled() ? "true" : "false",
             flightlogFull()    ? "true" : "false",
             flightlogActiveName(),
             (unsigned long)flightlogFreeBytes(),
             (unsigned long)flightlogDropped());
    out += buf;
    for (uint8_t i = 0; i < n; i++) {
        snprintf(buf, sizeof(buf),
                 "%s{\"name\":\"%s\",\"session_id\":%lu,\"records\":%lu,\"bytes\":%lu,\"active\":%s}",
                 i ? "," : "", fi[i].name, (unsigned long)fi[i].sessionId,
                 (unsigned long)fi[i].records, (unsigned long)fi[i].bytes,
                 fi[i].active ? "true" : "false");
        out += buf;
    }
    out += "]}";
    server.send(200, "application/json", out);
}

// GET /flight?name=mN&since_ms=<uptimeMs> → one page of a stored flight file.
// Same shape and cursor contract as /history, but session_id is the FILE's
// (the boot that recorded it), so the app rebuilds that mission as its own
// flight; `v` is the firmware version that RECORDED the file (from its
// header — the records themselves don't carry it); `more` says whether the
// file holds records beyond this page.
static void handleFlightGet() {
    addCORS();
    char name[12] = "";
    if (server.hasArg("name")) strlcpy(name, server.arg("name").c_str(), sizeof(name));
    uint32_t since = 0;
    if (server.hasArg("since_ms")) since = strtoul(server.arg("since_ms").c_str(), NULL, 10);

    uint32_t fileSession = 0;
    char     fileFw[16]  = "";
    if (!flightlogFileInfo(name, &fileSession, fileFw, sizeof(fileFw))) {
        server.send(404, "application/json", "{\"ok\":false,\"err\":\"no such flight\"}");
        return;
    }
    HistRecord chunk[10];
    uint32_t   avail = 0;
    int32_t    got = flightlogRead(name, since, chunk, 10, &avail, NULL);
    if (got < 0) {
        server.send(404, "application/json", "{\"ok\":false,\"err\":\"no such flight\"}");
        return;
    }

    server.setContentLength(CONTENT_LENGTH_UNKNOWN);
    server.send(200, "application/json", "");
    char head[96];
    snprintf(head, sizeof(head), "{\"session_id\":%lu,\"v\":\"%s\",\"more\":%s,\"records\":[",
             (unsigned long)fileSession, fileFw, (avail > HISTLOG_PAGE_MAX) ? "true" : "false");
    server.sendContent(head);

    String recsOut;
    recsOut.reserve(2048);
    uint16_t emitted = 0;
    uint32_t cursor  = since;
    while (got > 0 && emitted < HISTLOG_PAGE_MAX) {
        for (int32_t i = 0; i < got && emitted < HISTLOG_PAGE_MAX; i++) {
            if (emitted > 0) recsOut += ',';
            appendHistRecord(recsOut, &chunk[i]);
            cursor = chunk[i].uptimeMs;
            emitted++;
            if (recsOut.length() > 1536) { server.sendContent(recsOut); recsOut = ""; }
        }
        if (emitted < HISTLOG_PAGE_MAX) got = flightlogRead(name, cursor, chunk, 10, NULL, NULL);
    }
    if (recsOut.length()) server.sendContent(recsOut);
    server.sendContent("]}");
    server.sendContent("");
}

// POST /flight/delete {"name":"mN"} — refuses the active file. The app calls
// this after a verified import; boot-time pruning is the backstop if it never
// does, so the partition can't silently fill.
static void handleFlightDelete() {
    addCORS();
    StaticJsonDocument<64> req;
    if (deserializeJson(req, server.arg("plain"))) { server.send(400, "text/plain", "Bad JSON"); return; }
    const char* name = req["name"] | "";
    if (name[0] && !strcmp(name, flightlogActiveName())) {
        server.send(409, "application/json", "{\"ok\":false,\"err\":\"active\"}");
        return;
    }
    if (!flightlogDelete(name)) {
        server.send(404, "application/json", "{\"ok\":false,\"err\":\"no such flight\"}");
        return;
    }
    server.send(200, "application/json", "{\"ok\":true}");
}

void telemetryBegin() {
    telemetrySessionId();       // app uses this to detect mid-flight reboots
    wifiConnect();

    server.on("/status",    HTTP_GET,     handleStatus);
    server.on("/status",    HTTP_OPTIONS, handleOptions);
    server.on("/telemetry", HTTP_GET,     handleTelemetry);
    server.on("/telemetry", HTTP_OPTIONS, handleOptions);
    server.on("/history",   HTTP_GET,     handleHistory);
    server.on("/history",   HTTP_OPTIONS, handleOptions);
    server.on("/flights",       HTTP_GET,     handleFlights);
    server.on("/flights",       HTTP_OPTIONS, handleOptions);
    server.on("/flight",        HTTP_GET,     handleFlightGet);
    server.on("/flight",        HTTP_OPTIONS, handleOptions);
    server.on("/flight/delete", HTTP_POST,    handleFlightDelete);
    server.on("/flight/delete", HTTP_OPTIONS, handleOptions);
    server.on("/cruise",    HTTP_POST,    handleCruise);
    server.on("/cruise",    HTTP_OPTIONS, handleOptions);
    server.on("/waypoint",  HTTP_POST,    handleWaypoint);
    server.on("/waypoint",  HTTP_OPTIONS, handleOptions);
    server.on("/mission",       HTTP_GET,     handleMissionGet);
    server.on("/mission",       HTTP_POST,    handleMission);
    server.on("/mission",       HTTP_OPTIONS, handleOptions);
    server.on("/mission/clear", HTTP_POST,    handleMissionClear);
    server.on("/mission/clear", HTTP_OPTIONS, handleOptions);
    server.on("/pid",       HTTP_POST,    handlePid);
    server.on("/pid",       HTTP_OPTIONS, handleOptions);
    server.on("/led",       HTTP_POST,    handleLed);
    server.on("/led",       HTTP_OPTIONS, handleOptions);
    server.on("/audio",     HTTP_POST,    handleAudio);
    server.on("/audio",     HTTP_OPTIONS, handleOptions);
    server.on("/test/lowvolt", HTTP_POST,    handleTestLowVolt);
    server.on("/test/lowvolt", HTTP_OPTIONS, handleOptions);
    server.on("/bilge",     HTTP_POST,    handleBilge);
    server.on("/bilge",     HTTP_OPTIONS, handleOptions);
    server.on("/radar",     HTTP_POST,    handleRadar);
    server.on("/radar",     HTTP_OPTIONS, handleOptions);
    server.on("/depth",     HTTP_POST,    handleDepth);
    server.on("/depth",     HTTP_OPTIONS, handleOptions);
    server.on("/calibrate_mag/start", HTTP_POST,    handleCalibrateMagStart);
    server.on("/calibrate_mag/start", HTTP_OPTIONS, handleOptions);
    server.on("/calibrate_mag/abort", HTTP_POST,    handleCalibrateMagAbort);
    server.on("/calibrate_mag/abort", HTTP_OPTIONS, handleOptions);
    server.begin();
    if (boatIP.length()) {
        Serial.printf("HTTP up at http://%s/\n", boatIP.c_str());
    }

    // Hand the server to a core-0 task. From here on, handleClient()/wifiMaintain()
    // run ONLY here — never on the control loop (core 1) — so a blocked socket
    // send on a bad link can never stall RC/FSM/failsafe. server is touched only
    // by this task after this point.
    xTaskCreatePinnedToCore(networkTask, "net", NET_TASK_STACK, NULL, 1, &netTaskHandle, NET_TASK_CORE);
}

// Owns all networking. A blocking send here delays only telemetry (expendable);
// the control loop is on the other core and never waits behind it.
static void networkTask(void*) {
    static uint32_t lastWifiPubMs   = 0;
    static uint32_t lastAlarmHornMs = 0;
    for (;;) {
        server.handleClient();
        wifiMaintain();
        flightlogService();     // commit queued mission records (open-append-close)
        // Sample link state ~2 Hz so histlog/telemetry can report it. Cheap local
        // driver reads, kept on core 0 — the control loop never calls WiFi.
        uint32_t now = millis();
        if (now - lastWifiPubMs >= 500) {
            lastWifiPubMs = now;
            bool assoc   = (WiFi.status() == WL_CONNECTED);
            wifiAssocPub = assoc;
            wifiRssiPub  = assoc ? (int8_t)WiFi.RSSI() : 0;
        }

        // Low-voltage alarm horn — serviced HERE (core 0) on purpose: the DF1201S
        // UART is already a core-0-only peripheral (POST /audio), and audioPlay()'s
        // mandatory pause+50 ms would otherwise block the control loop. This runs
        // UNCONDITIONALLY — no client, no WiFi association required — because the
        // alarm's whole purpose is the app-closed case. handleClient()/wifiMaintain()
        // above are non-blocking when idle, so nothing gates or stalls this poll.
        if (lowVoltActive()) {
            if (audioAvailable() && now - lastAlarmHornMs >= LOWVOLT_HORN_INTERVAL_MS) {
                lastAlarmHornMs = now;
                audioPlay(AUDIO_HORN);
            }
        } else {
            lastAlarmHornMs = 0;    // next latch fires the horn immediately
        }

        vTaskDelay(1);          // yield ~1 tick; telemetry is best-effort
    }
}
