ryanmio/legend-class-autonomous-cutter/firmware/legend_cutter/histlog.h

// histlog.h
// Onboard telemetry history — a RAM ring buffer of compact records, recorded
// continuously whether or not WiFi/the app is connected. On reconnect the app
// pulls whatever it missed via GET /history (handler in telemetry.cpp) so the
// flight log stays unbroken across a WiFi dropout.
//
// Uniform-rate retention: capture is 1 s, so any dropout of ≤20 min is recorded
// entirely at 1 s. If the app has been gone longer than HISTLOG_COARSEN_AFTER_MS,
// the ring coarsens ONCE — it retroactively thins the stored data to
// HISTLOG_COARSE_MS spacing and stores at that rate thereafter, so the whole
// ring is a single uniform interval (2 s → ~40 min). Capture itself stays at
// 1 s: the flash log (flightlog.h) is not RAM-bound and keeps every sample, so
// ring records carry non-contiguous seq while coarsened. This one-time thin
// runs on core 1 only while the app is absent (that is its trigger), so no
// /history read races it; histlogCoarsening() gates the read as a backstop.
//
// RAM-only by design: a reboot clears it, but the app already ends a flight on
// a reboot (session_id change), so the ring never holds data the system would
// otherwise have kept. Sizing/cadence is in config.h (HISTLOG_CAPACITY,
// HISTLOG_INTERVAL_MS, HISTLOG_COARSE_MS, HISTLOG_COARSEN_AFTER_MS).
//
// This module only RECORDS and exposes a read API; it never touches outputs,
// WiFi, or the live /telemetry contract — flashing it changes no behavior.

#pragma once

#include <Arduino.h>

// One buffered sample. Numeric optionals use a sentinel (INT16_MIN / -1) when
// the source was unavailable at capture time, so /history can omit them exactly
// as the live /telemetry payload does. lat/lon are valid only when HIST_F_GPS_FIX.
struct HistRecord {
    uint32_t seq;          // monotonic per boot; ordering + the app's page cursor
    uint32_t uptimeMs;     // millis() at capture; app maps to wall-clock on sync
    int32_t  lat1e7;       // degrees × 1e7 (valid only if gps_fix flag set)
    int32_t  lon1e7;
    int32_t  wpLat1e7;     // active waypoint, deg × 1e7 (valid only if WP_SET flag)
    int32_t  wpLon1e7;     // — lets a backfilled gap reconstruct the leg + markers,
                           //   so a multi-waypoint mission plays back unbroken.
    int16_t  heading10;    // true heading, deg × 10 (always present)
    int16_t  course10;     // GPS course, deg × 10  (INT16_MIN = n/a)
    int16_t  speedKts100;  // knots × 100           (INT16_MIN = n/a)
    int16_t  escUs;        // commanded ESC µs
    int16_t  rudderUs;     // commanded rudder µs
    int16_t  battCv;       // bus volts × 100       (INT16_MIN = n/a)
    int16_t  battCa;       // amps × 100            (INT16_MIN = n/a)
    int16_t  depthCm;      // depth, cm             (-1 = no reading)
    int16_t  wpDist10;     // waypoint distance, m × 10 (-1 = n/a)
    uint8_t  mode;         // low nibble: 0 idle/unknown, 1 MANUAL, 2 AUTO, 3 FAILSAFE;
                           // high bits pack HIST_MODE_F_* (flags byte is full)
    uint8_t  sats;
    uint8_t  flags;        // HIST_F_* bitfield
    uint8_t  wpIdx;        // active leg, 0-based (valid only if WP_SET flag)
    uint8_t  wpCount;      // total legs in the mission (valid only if WP_SET flag)
    int8_t   rssiDbm;      // STA RSSI dBm (valid only if WIFI_ASSOC flag; 0 = not associated)
};

static const uint8_t HIST_F_GPS_FIX      = 1 << 0;
static const uint8_t HIST_F_WP_SET       = 1 << 1;
static const uint8_t HIST_F_CAPTURED     = 1 << 2;
static const uint8_t HIST_F_PUMP         = 1 << 3;
static const uint8_t HIST_F_FAILSAFE_ACK = 1 << 4;
// Was the boat associated to the AP at capture time? Recorded on every sample so
// a backfilled gap reveals whether the boat left the hotspot (assoc=0) or stayed
// on it while only the app's socket died (assoc=1). Reuses the old struct pad +
// one free flag bit — zero added bytes per record.
static const uint8_t HIST_F_WIFI_ASSOC   = 1 << 5;
// Forward + mid bilge probes, LATCHED reads (bilge.h) — a raw read can miss a
// sub-second contact that the loop-rate pump FSM acts on. Recorded so a mission
// flown out of WiFi range still answers where water reached and when. Files
// recorded before this read both bits clear, i.e. dry.
static const uint8_t HIST_F_BILGE_FWD    = 1 << 6;
static const uint8_t HIST_F_BILGE_MID    = 1 << 7;

// The flags byte is full, so extra bits pack into `mode`'s spare high bits —
// recSize stays 48 and every existing flight file remains readable. Serializers
// must mask with HIST_MODE_MASK before decoding the mode code.
static const uint8_t HIST_MODE_MASK         = 0x0F;
static const uint8_t HIST_MODE_F_BILGE_REAR = 1 << 7;   // rear probe latched wet

// A reader's snapshot of the ring window. The control loop appends once a
// second, which advances the window; a paged read must resolve every index
// against ONE snapshot, or it skips a record per append once the ring is full.
// Take a view at the start of a read pass and index only through it.
struct HistView {
    uint16_t oldest;   // ring slot holding logical index 0
    uint16_t count;    // records visible in this view
};

void     histlogBegin();                  // reset the ring (call once in setup)
void     histlogUpdate();                 // rate-limited capture (call every loop)
HistView histlogView();                   // snapshot the window for one read pass
const HistRecord* histlogViewAt(const HistView& v, uint16_t i);  // i=0 oldest; NULL if oob
bool     histlogCoarsening();             // true only during the one-time in-place thin
