ryanmio/legend-class-autonomous-cutter/(commit log)

2026-03-15 add sonar bench test (RCWL-1655)
2026-03-18 add test_05_deckgun bench test (continuous pan servo)
2026-04-19 test_06_i2c_pca9685: PASS — PCA9685 at 0x40 confirmed
2026-04-25 test_03_ibus_passthrough: add NOTES, rewrite sketch with pass/fail gates
    [test_03_ibus_passthrough.ino]
2026-04-25 test_03_ibus_passthrough: PASS — channel-freeze failsafe detection
    Flysky receivers keep streaming valid frames after signal loss with
    channel values frozen at failsafe presets, so the previous no-frame
    timeout never triggered. Detect failsafe by watching channel values
    freeze for 500 ms instead. Kept the no-frame timeout as a secondary
    path for a fully disconnected receiver.
    Rewrote the sketch as a 3-stage state machine that prints one PASS
    line per gate and goes silent after all pass — no more per-frame
    firehose.
    [test_03_ibus_passthrough.ino]
2026-04-25 test_07_ibus_rudder: PASS (servo-only) — stick-to-rudder loop verified
    Closes the manual control path: transmitter stick → ESP32 (iBUS) →
    PCA9685 → rudder servo. State machine auto-verifies signal acquired,
    full-left, and full-right. After the range gates pass, the rudder
    stays live for visual checks.
    Defaults to CH1 (right-stick horizontal) to match Mode-2 muscle
    memory. Linkage-binding check deferred until rudder + dogbone are
    installed in the hull.
    [test_07_ibus_rudder.ino]
2026-04-25 add test_08_ibus_esc bench test (transmitter→ESC→motor)
    Closes the throttle control loop. State machine with three pass gates
    (arm-on-neutral, throttle advance, return to neutral) and a LIVE phase
    after the range test for visual + failsafe verification.
    Safety design:
    * Motors stay at 1500 µs until throttle confirmed at neutral after
    signal acquired — boot with stick up does NOT spin motors.
    * Output capped at MAX_FWD_US (1800 µs / 60%) for the test.
    * Reverse clamped off by default (ALLOW_REVERSE).
    * Channel-freeze AND no-frame failsafe paths from test_03.
    * Failsafe disarms back to the neutral check — re-arm requires the
    operator to re-center the stick.
    Throttle defaults to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
    [test_08_ibus_esc.ino]
2026-04-25 test_08_ibus_esc: PASS — both motors spin under transmitter control
    Range gates 1/3 through 3/3 passed; both port and starboard motors
    spinning as expected on throttle advance and stopping at neutral.
    Documented the CL9030 power-switch gotcha: switch OPEN = ESC ON.
    Splicing the switch closed disables the ESC silently (no beep, no
    LED). Snip the switch out completely if you don't want to keep it.
    Failsafe-under-load check deferred to the in-hull test.
2026-04-26 add test_09_icm20948_imu bench test
    Initializes the SparkFun ICM-20948 on I2C (0x68, SDA=21/SCL=22) and
    streams heading / pitch / roll at 2 Hz. PASS/FAIL on init.
    Boots with an annotated I2C bus scan that reports PCA9685 (0x40),
    INA219 (0x41), and the IMU (0x68) so we can confirm the full bus is
    healthy before suspecting any one device.
    Heading is uncalibrated — uses raw accel + AK09916 mag with the
    textbook tilt-comp formula, no hard/soft-iron cal and no axis remap.
    NOTES.md flags this so it isn't mistaken for a true compass bearing
    later. Uses the SparkFun lib's basic read path; no DMP, so no
    library-internal #define needed.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
    [test_09_icm20948_imu.ino]
2026-04-26 add test_09b_imu_isolation diagnostic
    Standalone I2C scan + WHO_AM_I read for the ICM-20948. Run with the
    IMU as the only device on the bus to isolate whether the chip itself
    is alive or whether the failure is a shared-bus interaction.
    Beyond the address ack, this also reads register 0x00 and verifies it
    returns 0xEA (the ICM-20948 WHO_AM_I value), which proves bidirectional
    I2C communication rather than just an address ack. Reports a clear
    PASS / FAIL with the most likely cause for each failure mode. Re-runs
    every 3 seconds so wires can be wiggled while watching the output.
    Bus throttled to 100 kHz to rule out signal-integrity issues.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
    [test_09b_imu_isolation.ino]
2026-04-26 test_09_icm20948_imu: PASS — heading/pitch/roll responding
    Bench test PASS. Heading sweeps as the board rotates, pitch and roll
    respond to tilt, accel magnitude reads ~1000 mg at rest.
    Root cause of the initial "I2C bus dead" failure was a Wago lever
    connector with a bad grip on the IMU power pigtail — IMU unpowered
    while still connected to SDA/SCL. Body diodes from the chip's I/O
    pads leak current into the floating VCC rail, dragging bus voltages
    enough to break communication for the other devices. Re-seating the
    Wago fixed it. Captured this lesson in NOTES so the failure mode is
    documented for future debugging.
    The diagnostic sketch test_09b_imu_isolation lives on in the tree as
    a ge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
2026-04-26 add test_10_bn220_gps bench test
    State machine with three pass gates: bytes-arriving, valid-NMEA-parsed,
    position-fix-acquired. After fix, streams 1 Hz status (sats, HDOP,
    lat/lon, alt, UTC) so the operator can verify the fix updates while
    moving.
    UART2 remapped to GPIO 17 (RX, ← BN-220 TX) and GPIO 18 (TX, → BN-220
    RX) to avoid the iBUS pin on GPIO 16 (test_03). Default 9600 baud
    matches BN-220 factory settings. TinyGPSPlus library.
    NOTES documents the cold-start TTFF expectations so PASS 3/3 isn't
    mistakenly chased indoors mid-room.
    [test_10_bn220_gps.ino]
2026-04-26 test_10_bn220_gps: PASS — 6 sats, fix wire colors and bench vs boat pins
2026-04-26 add test_10b_bn220_gps_boat; sync test_10 sketch to corrected bench pins
    Bench test_10's .ino had RX=17/TX=18 from my original write, but the
    working bench config (per the updated NOTES.md result block) is
    RX=18/TX=17. Fixed the .ino so the pins match the documented PASS
    config — green (GPS TX) on GPIO 18, white (GPS RX) on GPIO 17.
    Cloned to test_10b for the in-hull wiring: GPS TX (green) on GPIO 4
    per the project pinout, GPS RX (white) still on GPIO 17. Same state
    machine and pass gates as test_10. Hint text leans on the lesson
    from the IMU debug — if the GPS LED is dark, multimeter the BN-220's
    own VCC pad before chasing data-line theories.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
    [test_10b_bn220_gps_boat.ino]
2026-04-26 test_10b: swap GPS RX/TX pins for in-boat reverse-wiring check
    In-hull debugging: green/white may be physically reversed at the ESP
    end, and re-wiring inside the boat is impractical. Swap the pin
    assignments in the sketch (RX=17, TX=4) so a re-flash tests the
    reversed mapping without the operator needing to touch the wires.
    If this flash starts streaming valid NMEA, the bench convention
    (green→ESP RX) was reversed during the boat install. We can either
    keep this swap permanent or relabel the cable.
    [test_10b_bn220_gps_boat.ino]
2026-04-26 test_10b: revert pin swap — pin direction is not the issue
    Per the BN-220 manual: blue LED = TX data output, red LED = PPS fix.
    Blue LED has been off in every boat config tried, which means the
    GPS has not actually transmitted NMEA at any point — the 'chars=1
    stuck' was noise on the line, not real data. Pin direction can't
    matter when the source isn't transmitting. Reverting to the
    documented boat pinout (RX=4 / TX=17) so debugging focuses on power
    to the GPS module.
    [test_10b_bn220_gps_boat.ino]
2026-04-27 add test_11_dfplayer bench test
    Plays track 1 on startup and every 20 s. Wiring: ESP32 RX=GPIO25,
    TX=GPIO26 (opposite of current config.h — note flagged in NOTES).
    Audio chain: DFPlayer → mini amp → 2 speakers.
2026-04-27 test_11_dfplayer: switch from SoftwareSerial to HardwareSerial(2)
    ESP32 Arduino core does not ship SoftwareSerial.h by default. Bench
    test has all three UARTs free, so use HardwareSerial(2) on the same
    custom pins (25/26) — no extra library required. NOTES updated to
    flag that main firmware still uses SoftwareSerial out of necessity
    (UART1=iBUS, UART2=GPS) and points to EspSoftwareSerial.
2026-04-27 test_11_dfplayer: swap ESP32 RX/TX pins (26/25)
    begin() failed on first try. Swapping ESP32 RX/TX is one of the most
    common UART bringup mistakes. New mapping (ESP32 RX=GPIO26, TX=GPIO25)
    also matches legend_cutter/config.h, so the boat firmware reuses this
    wiring as-is. Original "rx in 25, tx in 26" was DFPlayer-side labels.
    [test_11_dfplayer.ino]
2026-04-27 test_11_dfplayer: add blind-mode fallback + raw byte dump
    When dfPlayer.begin() fails (no ACK from module), fall back to
    begin(serial, isACK=false, doReset=false) and try to play track 1
    without expecting any response. In blind mode, also dump every raw
    byte the ESP32 receives on the DFPlayer TX line.
    This isolates the failure:
    - Audio plays in blind mode → return path is the only broken link
    (DFPlayer TX wire, RX pin, or DFPlayer firmware not sending ACK).
    - Still silent → forward path is broken (TX wire, GND, power, or
    DFPlayer not actually receiving commands).
    [test_11_dfplayer.ino]
2026-04-27 test_11_dfplayer: rewrite for DF1201S (the actual module)
    The module is a DFRobot DF1201S / DFPlayer Pro (SKU DFR0768), NOT a
    DFPlayer Mini. They look superficially similar but speak entirely
    different protocols:
    DFPlayer Mini : 9600 baud, binary frames, DFRobotDFPlayerMini
    DF1201S : 115200 baud, AT commands, DFRobot_DF1201S
    The earlier sketch was talking the wrong protocol at the wrong baud,
    so begin() always failed and the blind-mode raw dump produced
    unreadable garbage (Mini at 9600 sampling DF1201S at 115200).
    Switched to the DFRobot_DF1201S library, 115200 baud, AT-style API
    (begin / setVol / switchFunction(MUSIC) / setPlayMode(SINGLE) /
    playFileNum / enableAMP). Pins u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
    [test_11_dfplayer.ino]
2026-04-27 test_11_dfplayer: align with working Fitz reference (pins 26/27, 3.3V)
    Library/baud swap to DF1201S alone was not enough — begin() still
    timed out at 5 V on GPIO 25/26. Cross-referenced the working
    EdmundFitzgeraldController/firmware/dfplayer_diagnostic sketch and
    fixed three deltas:
    - Pins: ESP32 TX=GPIO26, RX=GPIO27 (was 25/26)
    - VIN: 3.3V (was 5V — 5V needs a level shifter on TX or begin fails)
    - Settle delay after Serial2.begin: 1000 ms (was 200 ms)
    User must physically move one wire from GPIO 25 → GPIO 27 and switch
    VIN from 5V → 3.3V on the breadboard.
    [test_11_dfplayer.ino]
2026-04-27 test_11_dfplayer: align pin constants with user's physical wiring
    Pin constants and header docs are now consistent with the bench
    wiring: DF1201S RX → ESP32 GPIO 26 (ESP32 TX line), DF1201S TX →
    ESP32 GPIO 25 (ESP32 RX line). Either pin pair works on ESP32 — kept
    25/26 to match the user's wires and config.h.
    The remaining unresolved-in-code issue is VIN: the working Fitz
    reference uses 3.3V because 5V VIN can leave the DF1201S RX threshold
    above the ESP32's 3.3V drive level, causing begin() to time out.
    Hardware change still required.
    [test_11_dfplayer.ino]
2026-04-29 add test_12_led_lights direct-drive LED bringup
    One-shot test: walks GPIO 18 (nav), 19 (bridge/interior), 23 (deck/
    flood) high for 3 s each, then all three for 3 s, then prints PASS
    and idles. No MOSFET or PCA9685 — direct GPIO drive only.
    Pins picked from outside the reserved set (iBUS/GPS/I²C/PCA9685/
    DFPlayer/ESC/servo) — all general-purpose, output-capable, non-
    strapping.
    NOTES covers per-pin current budget (12 mA continuous, 40 mA absolute
    max), resistor sizing, and when to switch to a MOSFET driver.
2026-04-29 add test_13_ina219_battery bringup + 4S LiPo SoC
    Three pass gates: INA219 found at 0x41, pack voltage in 10.0-17.5 V
    band, and current reading finite. After PASS, streams 1 Hz telemetry
    with V_bus / V_shunt / V_pack / V_per_cell / I / P / SoC% and a
    state label (FULL / good / ok / ALARM / RTH / DEAD).
    Matches main firmware: same library (Adafruit INA219), same address
    (0x41), same calibration (setCalibration_32V_2A), same alarm/RTH
    thresholds as battery.cpp / config.h.
    Note in NOTES: 32V/2A range will saturate current above ~3 A —
    sufficient for bringup and idle-current sanity, but the runtime boat
    firmware needs a lower shunt or INA226/228 for motor-current logging.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
2026-04-30 test_13_ina219_battery: clarify INA219 is sufficient for SoC%
    Earlier wording made it sound like the INA219 is a stopgap for
    battery monitoring. It isn't. Voltage measurement is independent of
    the shunt and stays accurate at any current, and SoC% on this build
    is voltage-based — so the stock board with default calibration is
    the right part for the use case.
    The lower-shunt / INA226 / INA228 advice only applies to motor-
    current telemetry, which the project doesn't need. Reworded both
    the .ino header and NOTES so it's not mistaken for a part-choice
    warning.
    [test_13_ina219_battery.ino]
2026-05-01 test_13_ina219_battery: PASS — voltage-only config
    Result: PASS in voltage-only configuration. VIN- is disconnected
    because an early bringup miswire short-circuited the on-board 0.1 Ω
    shunt across the battery. Current readings now saturate but voltage
    is unaffected, and SoC% is voltage-based — so the part still does
    the job for remaining-battery-percent monitoring.
    NOTES updated with the final wiring, the bringup-fail story, and
    followups for anyone who later wants real current measurement
    (replace breakout, splice in series with the 14 V bus, etc.).
2026-05-02 test_13_ina219_battery: PASS (real this time)
    Final config: VIN+ jumpered to VIN- on the breakout. V_bus now
    reads 15.00 V vs multimeter 15.12 V (Δ 0.12 V, well within INA219
    accuracy). SoC = 50% [good] on a healthy 4S at storage-ish charge.
    Earlier "PASS (voltage-only, VIN- disconnected)" claim was wrong —
    floating VIN- gave a meaningless reading that happened to look like
    a plausible low-4S number (13.6 V), but multimeter ground-truth at
    the same time read 15.12 V. Per the INA219 datasheet bus voltage
    is measured at VIN-, so VIN- needs to be tied to battery voltage
    for the reading to be real. Jumpering across the (blown) shunt does
    that.
    NOTES rewritten with the corrected story so nob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
2026-05-03 test_14_systems_check: post-waterproofing bringup test
    Six pass gates verifying every critical subsystem without moving any
    servo or ESC: I2C scan, PCA9685 ack, INA219 voltage, ICM-20948 IMU,
    GPS NMEA (no fix required), DFPlayer Pro UART ack. Streams a 1 Hz
    health line afterward so dropouts during reassembly are obvious.
    [test_14_systems_check.ino]
2026-05-03 test_15_rudder_max_deflection: find safe rudder servo limits
    Sweep the rudder by hand with the RC stick and read back the most-extreme
    µs values commanded so far, every 2 s. Stop sweeping just before the
    linkage binds; the last printed pair becomes RUDDER_MIN_US / RUDDER_MAX_US
    in config.h. 'r' on serial resets if you overshoot.
    [test_15_rudder_max_deflection.ino]
2026-05-03 test_14_systems_check: harden GPS step
    Per test_10b NOTES, when bytes arrive but no NMEA parses the cause is
    usually a flaky TX wire or a non-default baud (BN-220 default is 9600
    but a previous sketch may have reconfigured it). Boat just had a 1-byte
    fail in the 5 s window after waterproofing reassembly.
    Changes:
    - 8 s window instead of 5 s
    - on FAIL with bytes>0, probe 38400 and 4800 before giving up; if a
    fallback baud responds, name it explicitly
    - byte-count-aware diagnostics: <50 bytes suggests a marginal/loose TX
    wire, not wrong baud
    - live loop promotes 5/6 from FAIL to RECOVERED if NMEA starts parsing
    later (so wiggling the green wire shows as a recovery line)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
    [test_14_systems_check.ino]
2026-05-03 test_14_systems_check: revert GPS step to match test_10b exactly
    Drop the baud-fallback probe and 8 s window — test_10b passed at 5 s
    and 9600 only. Keeping the live-loop RECOVERED message so wire wiggling
    shows up.
    [test_14_systems_check.ino]
2026-05-03 GPS: white=TX, green=RX — sketches, config, notes, test_14
    This batch of BN-220s has the wire colors REVERSED from the typical
    convention. Confirmed empirically 2026-05-03 — test_10b PASS in the
    boat with 5 sats and a real fix at lat=38.864662, lon=-77.184843.
    Root cause of the prior weeks of "1 byte then silence" failures: the
    boat harness was already wired green→GPIO 4 / white→GPIO 17 (correct
    for this batch), but the firmware had GPS_RX_PIN=4 assuming green=TX,
    so the ESP32 was listening to the silent input pin while the module
    talked into the deaf one.
    - legend_cutter/config.h: GPS_RX_PIN=17, GPS_TX_PIN=4
    - test_10: comment swap (pin numbers unchanged — bench wiring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
    [config.h, test_10_bn220_gps.ino, test_10b_bn220_gps_boat.ino, test_14_systems_check.ino]
2026-05-03 test_14_systems_check: PASS — all 6 subsystems nominal
    Post-waterproofing bringup confirmed electrically sound. I2C scan,
    PCA9685, INA219, ICM-20948, GPS NMEA, and DF1201S all green on
    2026-05-03. GPS step passed after the white=TX / green=RX fix.
2026-05-03 test_15_rudder_max_deflection: PASS — RUDDER_MIN/MAX_US = 1330/1670
    Observed safe extremes 1334 / 1683 µs; chose symmetric ±170 from 1500
    neutral. Added RUDDER_MIN_US / RUDDER_MAX_US to config.h next to
    PWM_MIN/MAX. motors.cpp clamp wiring still TODO (deferred to firmware
    integration).
    Test also surfaced a persistent ~1 frame/sec iBUS checksum mismatch that
    did not affect min/max capture but should be diagnosed before we depend
    on iBUS for on-water control. Notes recorded in test NOTES.md.
2026-05-03 test_16_ibus_quality: iBUS frame loss counter for diagnosing checksum mismatches
    Counts good/bad frames over 5 s windows and prints loss percentage so
    configurations can be compared directly. Triggered by test_15's persistent
    ~1 warn/sec checksum mismatch, which test_03 surfaces but doesn't quantify.
    Tracks bad_checksum (header OK, checksum wrong), bad_header (32 bytes but
    wrong header — worse failure mode), and resync_bytes (bytes discarded
    hunting for header). 'r'+ENTER resets counters between mitigation attempts.
    [test_16_ibus_quality.ino]
2026-05-03 test_16_ibus_quality: log baseline 1.12% loss, defer fix to integration
    Baseline run with PCA still connected showed 1.12% steady frame loss with
    no bursts and frozen resync_bytes (startup hunt only). Single-frame errors
    won't disrupt control loop sampling, so continuing build. Real risk
    question is motor-load behavior — added to integration test list.
2026-05-03 test_16_ibus_quality: extend to drive ESCs + rudder under load
    Drives both ESCs from CH3 throttle and rudder from CH1 (clamped to
    RUDDER_MIN_US/MAX_US — first integration use of those values) while
    counting iBUS frame quality, bucketed into 5 throttle bands. Operator
    ramps throttle and watches per-band loss % to see whether motor EMI
    correlates with frame errors.
    'd' command dumps full histogram with good/bad counts per band.
    Failsafe neutralizes all outputs on iBUS loss.
    [test_16_ibus_quality.ino]
2026-05-03 test_17_manual_sailing: full manual control loop with reverse interlock
    Integration test that closes the manual sailing loop: sticks → iBUS →
    PCA9685 → both ESCs + rudder, exercising the production differential-
    thrust mixing math from motors.cpp.
    Stick scheme: CH1 rudder, CH2 reverse command (right-stick V), CH3
    forward throttle + reverse-enable interlock (left-stick V). Reverse only
    engages with both sticks committed (left all the way down, right below
    1500). Prevents bumped-stick reverse mid-cruise.
    Five auto-verified gates: arm-on-neutral, rudder L sweep, rudder R sweep,
    forward-with-rudder differential split observed, reverse interlock holds
    in phase A and engages in phase B. Ch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
    [test_17_manual_sailing.ino]
2026-05-03 test_18_deck_gun_pan: phase 1 — iBUS channel discovery
    Two-phase test for assigning a TX knob to the forward deck gun pan
    servo (PCA9685 ch8). Phase 1 (this commit) sniffs iBUS frame-to-frame,
    prints which channel is moving when the operator turns only the knob.
    No baseline, no PCA9685 driving — pure discovery.
    Phase 2 (separate commit, once channel is known) will replace the
    discovery block with: knob channel → ch8 pan servo, with no-frame
    failsafe and sweep-limit calibration mirroring test_15.
    NOTES.md flags the config.h:63 scaffold mismatch (CH_GUN_PAN 3 vs.
    actual ch8) — fixed in config.h after phase 2 passes.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
    [test_18_deck_gun_pan.ino]
2026-05-03 test_18_deck_gun_pan: phase 1 PASS (CH5), phase 2 — knob → ch8 servo
    Phase 1 result: CH5 (iBUS idx 4) is the dial. Logged sample sweep
    output in NOTES.md.
    Phase 2 (active): pass-through CH5 → PCA9685 ch8 with conservative
    clamp (1200..1800 µs default), running min/max display every 2 s
    for tightening the limits like test_15, plus channel-freeze and
    no-frame failsafes that hold pan at 1500 on signal loss.
    Phase 1 discovery sketch preserved in #if 0 block at bottom of .ino
    in case a future TX mapping needs re-discovery.
    [test_18_deck_gun_pan.ino]
2026-05-03 test_18_deck_gun_pan: handle continuous-rotation pan servo
    The forward deck gun's pan servo is continuous rotation, not positional
    as the config.h scaffold comment implies. µs commands rotation SPEED:
    1500 = stop, off-center = slew at proportional speed.
    - Add center deadband (PAN_DEADBAND_US ±30 µs) — force exact 1500 µs
    output when the knob is roughly centered, defeating the creep that
    continuous servos exhibit at the nominal "stop" pulse.
    - Tighten speed cap from ±300 to ±200 (1300..1700 µs) for controllable
    slew rate.
    - Reframe header comments + setup banner to make clear µs = speed not
    angle, and that there is no position feedback (operator must center
    knob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
    [test_18_deck_gun_pan.ino]
2026-05-03 test_18_deck_gun_pan: revert to phase 1 discovery, refactor for switch hunt
    Naive phase 2 passthrough (CH5 → ch8) doesn't work for this knob: the
    TX powers on with the knob at whatever position it was left in, so
    the gun starts spinning before the operator can center it. No way to
    fix that with a deadband alone.
    New plan (phase 3, TODO once phase 1 finds a switch channel): a TX
    toggle switch arms the pan motor. Switch off → forced 1500 µs (gun
    stopped) regardless of knob. Switch on → knob controls slew with a
    WIDE deadband (~±100 µs). Operator workflow: power on, deliberately
    center knob, then flip arm switch.
    This commit:
    - Adds #define ACTIVE_PHASE selector at top — flip 1↔2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
    [test_18_deck_gun_pan.ino]
2026-05-04 test_18_deck_gun_pan: phase 2 reframed for positional servo
    Pan servo swapped from FS90R (continuous) to MG90S/SG90-class
    (positional) on the bench. µs is now an angle command, not a speed.
    - ACTIVE_PHASE flipped back to 2.
    - Phase 2 header / comments / setup banner reframed: "POSITIONAL —
    µs = angle". Speed-cap framing replaced with angle-clamp framing.
    - Deadband narrowed from ±30 to ±15 — smaller deadband is plenty for
    filtering TX jitter on a positional servo (it was wide because
    continuous servos creep at 1500; positional servos hold position).
    - PAN_MIN_US/PAN_MAX_US 1300..1700 retained as conservative starting
    clamp — operator widens via the test_15 sweep p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
    [test_18_deck_gun_pan.ino]
2026-05-04 test_18_deck_gun_pan: PASS — knob CH5 → positional pan servo on PCA ch8
    Phase 2 final tunables:
    PAN_MIN_US = 1000
    PAN_MAX_US = 2000
    PAN_DEADBAND_US = 15
    PAN_REVERSE = true
    Full ±500 µs range exposed — linkage sweeps cleanly across entire
    knob travel without binding. Reverse flipped because the knob's
    natural CW direction was driving the gun CCW.
    Followups (not blocking, tracked in NOTES.md):
    - config.h:63: CH_GUN_PAN 3 → 8
    - config.h: add IBUS_CH_GUN_PAN (idx 4)
    - config.h:62 comment: positional 9g micro is correct post-swap; was
    scaffold guess that accidentally became right.
    [test_18_deck_gun_pan.ino]
2026-05-04 config.h: reconcile gun pan channel assignments with test_18 PASS
    Verified by test_18 phase 2 PASS (2026-05-04):
    - Deck gun pan servo wired to PCA9685 ch8, not ch3
    - Pan-control knob on iBUS CH5 (idx 4)
    - CH_GUN_PAN: 3 → 8
    - CH_BAY_DOOR_PORT: 8 → 3 (had been on ch8 — moved to the slot CH_GUN_PAN
    vacated. Bay door is still scaffold/UNVERIFIED; just resolves the conflict.)
    - Added IBUS_CH_GUN_PAN 4 alongside the other iBUS channel constants.
    - IBUS_CH_MODE 4 now flagged as conflicting with IBUS_CH_GUN_PAN. Test_18
    phase 1 follow-up confirmed no switches are mapped on this TX, so MODE
    needs a different home once a physical mode control is picked.
    - IBUS_CH_RUDDER 3 also fl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
    [config.h]
2026-05-05 test_17_manual_sailing: v2 — bottom-rest throttle, scaled rudder, slew limiter
    Operator feedback after v1 PASS uncovered four usability issues. Fixes:
    1. Throttle: stick rests at the BOTTOM (1000 µs), not center-sprung.
    Stick at/below THROTTLE_IDLE_MAX_US (1100) = idle. Stick lifted off
    idle = forward, scaled linearly to [1500..MAX_FWD_US]. So lifting
    the stick at all engages forward thrust, instead of needing to push
    past center.
    2. Re-arm: requires throttle at idle (≤1100), not all sticks at 1500.
    The old check was unreachable for a non-center-sprung throttle.
    3. Rudder: full stick range (1000..2000) now scales linearly to
    RUDDER_MIN_US..RUDDER_MAX_US (1330..1670)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
    [test_17_manual_sailing.ino]
2026-05-07 test_19_anchor_winch: binary knob → continuous winch on PCA ch9
    Knob hard-left (≤1050 µs) lowers anchor at slow speed (1350 µs);
    knob hard-right (≥1950 µs) raises (1650 µs); wide dead zone stops winch.
    Failsafe stops winch on iBUS loss.
    [test_19_anchor_winch.ino]
2026-05-07 test_20_wifi_leds: WiFi AP + WebSocket telemetry + LED HTTP control
    First WiFi/networking test. ESP32 broadcasts JSON at 10 Hz over ws://192.168.4.1:81
    and handles POST /led {light, state} to toggle GPIO 18/19/23.
    Five-gate pass criteria matching phone-app flow (connect → telemetry → each LED).
    Marks audit item 3f (WiFi telemetry) as in scope and addressed by this test.
2026-05-07 app: LED light switches on Systems screen, backed by telemetry state
    - types: add optional nav_on/bridge_on/deck_on booleans to TelemetryData
    - esp32Service: add setLed(ip, 'nav'|'bridge'|'deck', bool) → POST /led
    - SystemsScreen: add LIGHTS section; toggles read actual state from WS
    telemetry so they always reflect hardware truth (not just client-side state)
2026-05-07 app: fix undefined rendering, implement GPS map, add ScrollView
    - types: make all fields except v optional — partial firmware sends partial JSON
    - TelemetryScreen: build rows dynamically, only show fields present in broadcast
    - HelmScreen: use != null guards so absent fields show '--' not 'undefined°'
    - SystemsScreen: wrap in ScrollView with paddingBottom for E-STOP clearance
    - MapScreen: replace placeholder with Leaflet.js WebView — boat marker,
    track trail, real-time GPS injection via injectJavaScript, CENTER button,
    connection dot overlay; works with Expo Go (no native build needed)
2026-05-07 app: remove camera IP, add boat scanner, fix connection flow
    - Remove cameraIP from all routes/screens (no camera ESP on this boat)
    - FPVScreen: replace MJPEG stream with placeholder for future camera
    - HelmScreen: remove FPV from nav bar, fix nav calls to pass only ip
    - ConnectionScreen: remove camera IP field; add SCAN button that tries
    192.168.4.1 first (boat AP fast path) then scans 192.168.1/0.x and
    172.20.10.x in parallel; auto-connects on find
    - storageService: simplify to single IP (drop lastCamIP)
    - constants: remove DEFAULT_CAMERA_IP and CAMERA_STREAM_PATH
2026-05-07 test_20: STA mode (home WiFi → hotspot → AP fallback), add secrets template
    WiFi now tries home network first, then iPhone hotspot, then falls back to AP.
    Same pattern as the Fitz — phone keeps internet on hotspot, map tiles work.
    Add secrets.h.example with home + hotspot credential slots.
    Add **/secrets.h to .gitignore so credentials are never committed.
2026-05-07 test_20: switch to ESPAsyncWebServer — drop WebSocketsServer.h dependency
2026-05-07 test_20 + app: drop WebSocket, use HTTP polling — zero external lib dependency
    Firmware: WebServer.h only (built-in). Serves GET /telemetry + GET /status
    + POST /led. ArduinoJson is the only library to install.
    App: websocketService rewritten as 1 Hz HTTP polling with same exported API
    (connect/disconnect/subscribe/isConnected) — all screens unchanged.
    Remove WS_PORT from constants.
2026-05-07 app: safe-area fix, remove E-STOP, LIGHTS to top of Systems
    - New Screen.tsx wrapper (SafeAreaView) applied to all 9 screens so
    content is never hidden behind the iPhone notch or home indicator
    - EmergencyStop removed from all screens — not needed for this build
    - SystemsScreen: LIGHTS section promoted to top; Radar section removed
    (not on boat); Bay Doors and Anchors kept below for future wiring
    - MapScreen: HUD bottom offset reduced now that E-STOP overlay is gone
    - TypeScript clean (tsc --noEmit passes)
2026-05-07 app: MapScreen safe-area fix + test_21 WiFi+GPS sketch
    MapScreen: replace <Screen> wrapper with plain <View> + useSafeAreaInsets so
    the WebView fills edge-to-edge and the connection pill sits at insets.top+8
    instead of being clipped by SafeAreaView.
    test_21_wifi_gps: extends test_20 with BN-220 GPS (TinyGPSPlus on UART2,
    RX=GPIO17/white, TX=GPIO4/green, 9600 baud). /telemetry now includes
    gps_fix, sats, lat, lon, speed_kts, course when fix is valid. Raw NMEA
    mirrored to Serial for GATE 4 verification.
    [test_21_wifi_gps.ino]
2026-05-07 app: add back button to MapScreen
2026-05-08 test_22: magnetometer hard-iron calibration + live heading
2026-05-08 test_22: reduce Serial to 1 line/sec during spin, 0.5 Hz live
2026-05-08 test_22: silent spin window, print results once, 'H' for heading snapshot
2026-05-08 test_22: plateau detection — exits when ranges stop growing, not on timer
2026-05-08 test_22: add NOTES with calibration results, update FIRMWARE_AUDIT
2026-05-08 test_23: WiFi + GPS + IMU complementary filter heading
2026-05-08 test_23: Serial gate tests — type bearing for GATE 4, S for GATE 5
2026-05-09 test_23: add D diagnostic command — raw accel/mag/gyro snapshot
2026-05-09 test_23: fix axis remapping for X-up IMU wall mount
    [test_23_wifi_gps_imu.ino]
2026-05-09 test_23: add T tracking test — 360 spin proves relative heading accuracy
2026-05-09 test_23: tracking test silent — single pass/fail result only
    [test_23_wifi_gps_imu.ino]
2026-05-09 test_23: fix tracking pass threshold — shortest-path diff caps at 180 deg
    [test_23_wifi_gps_imu.ino]
2026-05-09 test_23: tracking test uses cumulative rotation — fixes 180-out-and-back ambiguity
    [test_23_wifi_gps_imu.ino]
2026-05-09 test_23: NOTES — tracking PASS, gates 2/3/6 deferred, gate 4 deferred to water
2026-05-09 test_24: add servo+sensors bench integration test
    PCA9685 rudder servo (ch2) and ICM-20948 IMU have never shared the I2C
    bus. This test proves both init cleanly, the rudder sweeps 1330–1670 µs
    (test_15 confirmed limits), and heading keeps updating with zero I2C
    errors during the sweep.
    Gates: I2C bus coexistence, WiFi connects, rudder sweep PASS/FAIL,
    heading variance < 5° during sweep, app sees rudder_us in /telemetry.
    [test_24_servo_sensors.ino]
2026-05-09 test_24: rewrite as closed-loop bench heading hold
    First closed-loop demo: set a target heading, rotate the boat by hand,
    rudder deflects proportionally to correct the error. More meaningful than
    a plain sweep — proves correct direction, proportional magnitude, and
    I2C bus coexistence (PCA9685 + ICM-20948) all in one test.
    Controller: rudder_us = NEUTRAL + Kp * error (Kp=3.0 µs/deg default).
    Gates: I2C bus, WiFi, correct rudder direction when off-target, rudder
    returns to neutral on-target, app sees heading_error + rudder_us.
    [test_24_servo_sensors.ino]
2026-05-09 test_24: PASS — heading hold confirmed, I2C bus coexistence proven
2026-05-09 test_25: GPS waypoint → haversine bearing → heading hold
    Full math pipeline bench test. App drops waypoint on map, computes
    bearing in TypeScript and shows it in the HUD. Firmware receives the
    waypoint via POST /waypoint, computes the same bearing in C++ haversine,
    feeds it into the test_24 proportional controller.
    Gate 3 (app vs firmware bearing agree within 1°) cross-validates the
    haversine math in both languages before trusting either. Gate 4 proves
    the controller closes the loop on a GPS-derived target.
    App: tap-to-set waypoint on map, green marker, bearing+distance HUD,
    red CLEAR WP button. MapScreen now posts to /waypoint on each tap.
2026-05-09 test_25: remove spurious MOUNTING_OFFSET_DEG — heading needs no offset
2026-05-09 fix: mag axis remapping wrong — chip Y=stern, chip X=up
    mr_x = my was using the stern axis causing heading = 180° - actual.
    mr_z = mx was using the up axis where the tilt formula needs down,
    causing heading to track pitch instead of yaw when the boat is tilted.
    Fix: mr_x = -my (negate stern to get bow), mr_z = -mx (negate up to
    get down). Restores test_22 offsets which were never the problem.
    Applied to test_23, test_24, and test_25.
    [test_23_wifi_gps_imu.ino, test_24_servo_sensors.ino, test_25_waypoint_heading.ino]
2026-05-09 test_25: zero mag offsets — test_22 values corrupt heading outdoors
    MAG_OFFSET_Z=-14.85 µT adds 14.85 to a ~18 µT horizontal field,
    causing 90-140° heading errors. Offsets were measured indoors with
    metal surroundings and are not valid outdoors. Formula fix (mr_x=-my,
    mr_z=-mx) is correct and stays. Recalibrate mag outdoors when boat
    is fully built.
    [test_25_waypoint_heading.ino]
2026-05-09 test_25: PASS — GPS waypoint → heading hold working
    Correct mag axis mapping: mr_x=-mz, mr_y=-my, mr_z=-mx (chip X=up, Y=port,
    Z=stern — confirmed by accelerometer tilt tests). Outdoor calibration offsets
    applied. Gate 4 result: 1.8° heading error, bow confirmed pointing at waypoint.
    Open bug noted in NOTES: rudder oscillates at 180° error (P-only controller
    singularity). Deferred — PD controller fix for test_26+.
    [test_25_waypoint_heading.ino]
2026-05-10 test_26: PASS — autonomous throttle + mode switch working
    Captured cruise=1653 µs spun both motors for 1000 ms; max heading drift 2.0°.
    First time the firmware has commanded the throttle on its own.
    Key changes that got the test out of false-PASS purgatory:
    - AUTO cruise µs now CAPTURED from the operator's peak throttle stick during
    the MANUAL passthrough (mapped through the same stick→ESC function used
    in MANUAL). Floor 1650 µs refuses AUTO if the operator never demonstrably
    cleared the deadband; cap 1750 µs limits hands-off cruise to ~50% forward.
    Hardcoded 1600 µs from earlier drafts sat inside this rig's deadband.
    - New G_WAIT_AUTO_CONFIRM gate prompts operator y/n aft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
    [freeze_diag.ino, test_26_mode_switch.ino]
2026-05-10 test_27: WIP — RC failsafe sketch + Mode enum + HTTP /cruise + telemetry
    Untested. Per the commit-per-test rhythm, this is the write-time commit;
    PASS commit follows once Ryan runs the four gates.
    What's new vs test_26:
    - Canonical Mode enum (MODE_MANUAL / MODE_AUTO / MODE_FAILSAFE) wired
    through a single state machine that decides outputs by mode rather than
    by gate. This is the shape the production firmware will inherit.
    - 3 s no-frame RC failsafe with sticky ACK: once tripped, the firmware
    refuses to re-engage AUTO until it observes a clean SwC=MANUAL frame —
    even after RC frames return. Prevents the runaway scenario where TX
    glitches mid-mission and recovers with the switc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
    [test_27_rc_failsafe.ino]
2026-05-10 test_27: drop hint-repeat + default cruise to 1700 µs
    Two operator-facing fixes Ryan called out:
    1. Removed HINT_INTERVAL_MS prompt repeat. Each phase now prints its
    prompt ONCE on entry. The boat sat there re-printing "STEP 2: POST
    cruise via HTTP, then flip SwC DOWN" every 12 s while Ryan was thinking
    — exactly the serial-monitor flooding pattern that's been called out
    repeatedly. The rule: print on transition, wait silently otherwise.
    2. cruise_us defaults to 1700 µs (known-good from test_26's 1653 µs spin).
    The test runs end-to-end without HTTP — flip SwC and go. POST /cruise
    still works for app-integration testing but is no longer a precondition
    for any gat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
    [test_27_rc_failsafe.ino]
2026-05-10 test_27: rc_loss_diag sketch + lower default cruise to 1660
    test_27 v1's RC failsafe failed live (motors kept running >5 s after TX
    off). Hypothesis: the FS-iA10B with TX failsafe configured "OFF" per
    channel falls back to firmware default = hold-last, so iBUS frames keep
    arriving with channels frozen at their last-received values. Our 3 s
    no-frame timeout never trips because the no-frame condition never
    happens.
    rc_loss_diag/ exposes one HTTP endpoint, GET /channels, that returns the
    10 iBUS channel values + frame age + frame counters. No motor outputs
    at all — PCA9685 is never initialized, so ESCs receive no PWM. ESC
    battery can be unplugged for extra safety. Operator hits /channels
    bef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
    [rc_loss_diag.ino, test_27_rc_failsafe.ino]
2026-05-10 Lock channel map after TX-side failsafe config; add detector to rc_loss_diag
    TX-side configuration completed by the transmitter agent locks in:
    - CH6 (idx 5) = SwD failsafe guard. SwD up = ~1000 µs in normal use;
    receiver outputs ~2000 µs (stored failsafe value) when TX is gone.
    - CH7 (idx 6) = SwA mode switch. Up = MANUAL (~1000), down = AUTO
    (~2000). Up is MANUAL because the FS-i6X forces switches up at TX
    boot, making MANUAL the safe boot state.
    handoff prompt.md: full channel map (idx 0..9) replaces the single SwC
    line. test_26's PASS used the old idx-5 mode location and is preserved as
    historical record; new tests must use the locked map.
    legend_cutter/config.h: reco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
    [config.h, rc_loss_diag.ino]
2026-05-10 test_27 v2: guard-based failsafe + new channel map
    PRIMARY trigger: ch[5] (CH6 / SwD failsafe guard) > 1500 µs sustained
    500 ms → MODE_FAILSAFE. This is the actual TX-loss signal for the
    FS-iA10B in this rig — the receiver streams frames continuously even
    with TX off, but overrides the configured-failsafe channel with the
    stored value (~2000 µs) on signal loss. Verified end-to-end via the
    rc_loss_diag detector before this commit.
    SECONDARY trigger: existing 3 s no-frame timeout retained as defense-
    in-depth. It won't fire on FS-iA10B today, but stays correct if a
    future receiver swap actually goes silent.
    Channel map updated to match TX-side config (locked 2026-05-10):
    IBUS_IDX_FAI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
    [test_27_rc_failsafe.ino]
2026-05-10 test_27: PASS — RC failsafe + Mode enum + sticky ACK working
    All four gates PASS:
    1/4 MANUAL detected at boot
    2/4 AUTO engages at cruise=1660 µs, motors spin
    3/4 TX off → CH6 guard trips → MODE_FAILSAFE, motors neutral
    4/4 TX on with SwA=AUTO refused (ACK_REQUIRED), flip UP clears ack,
    flip DOWN re-engages AUTO, motors spin again
    First firmware-detected RC failsafe in this project. The path that fires
    on FS-iA10B is the guard channel (ch[5] > 1500 sustained 500 ms), not
    the 3 s no-frame timeout — frames keep streaming on TX-off because the
    receiver is in hold-last mode. The 3 s timeout stays in place as
    defense-in-depth for receivers that genuinely go silent.
    Co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
    [test_27_rc_failsafe.ino]
2026-05-10 test_26: add stale-channel-map banner
    After test_27 PASS the iBUS channel layout changed: CH6 (idx 5) was the
    mode switch when test_26 was written; it's now the SwD failsafe guard,
    and the mode switch moved to CH7 (idx 6, SwA). test_26's channel
    constants are no longer correct for new code.
    Banner added to both the .ino header and NOTES.md so a future agent
    who lifts code from test_26 immediately sees the warning. Points at
    firmware/legend_cutter/config.h and handoff prompt.md as the canonical
    source for the current map. test_26's PASS gate results stand —
    preserved as historical record.
    (test_26 was the only sketch with stale mode-channel constants; all
    other tests either don't referenc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
    [test_26_mode_switch.ino]
2026-05-10 handoff prompt: rewrite for the post-test_27 phase
    Replaces the test_26-era content with a self-contained briefing for the
    agent who'll take Ryan from current state to the first pool test.
    Covers:
    - Rule zero (read prior tests + NOTES + memory before writing)
    - What's already proven (test_07..test_27) with stale-channel-map flag
    on test_26
    - Locked channel map post-2026-05-10
    - Failsafe semantics (primary guard + secondary no-frame + sticky ack)
    - Next two sketches scoped:
    test_28 — multi-waypoint mission (BENCH-ONLY, GPS-spoofed via a
    new POST /sim_gps endpoint; Ryan can't walk a 1.3m boat
    through a yard)
    test_29 — pool integration (single-waypoint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
2026-05-10 test_28: write multi-waypoint mission sketch (bench, GPS-spoofed)
    Inherits from test_27. Adds volatile mission storage, /mission and
    /sim_gps endpoints, capture-radius sequencer, mission-survives-failsafe
    semantics. 4 auto-detected gates. Pending first run.
    Divergences from handoff spec:
    - No /mission/start or /mission/stop (auto-arm on POST).
    - AUTO requires a mission; otherwise neutral.
    - Sequencer runs regardless of mode; only outputs are mode-gated.
    - FAILSAFE pauses mission (wp_idx and active flag persist).
    - 4 gates instead of 5; "rudder commands toward WP1" implicit.
    [test_28_multi_waypoint.ino]
2026-05-10 test_28: drop gate 4, add run.sh driver
    Gate 4 (failsafe-during-mission preserves wp_idx) is a code-review check,
    not a bench-discovery check — defer to test_29 which exercises it
    naturally. Sketch now ends at gate 3, summary table updated.
    run.sh walks gates 1-3 with prompts between curls so the operator can
    verify each Serial line. Default IP 192.168.1.194; pass $1 to override.
    [test_28_multi_waypoint.ino]
2026-05-10 test_28: PASS — multi-waypoint sequencer (bench, GPS-spoofed)
2026-05-10 test_29: write pool integration sketch
    Production-direction, no bench gates. Merges test_27 (Mode FSM,
    failsafe, /cruise, /telemetry, INA219) with test_25 (single /waypoint,
    haversine, heading-hold). Adds capture detection (sticky), live /pid
    tuning, /sim_gps for app dry-runs.
    Behavior changes from test_27:
    - AUTO cruise floor refusal removed; cruise=NEUTRAL valid (static
    heading-hold for AUTOPILOT_PLAN test_32 step 2).
    - AUTO without waypoint = neutral (test_27 had 'hold heading at entry').
    - AUTO with captured waypoint = neutral (sticky until waypoint
    cleared/moved).
    Out of scope per 2026-05-10 conversation: multi-waypoint, cross-track,
    Ki, GPS-loss, /estop, /rth, /set-home, /mode (p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
    [test_29_pool_integration.ino]
2026-05-10 test_29 + app pool readiness
    Firmware (test_29_pool_integration):
    - Rename telemetry batt_v / batt_a (was bus_v / shunt_ma) for app
    consistency. shunt is converted mA → A.
    App:
    - types: 'AUTONOMOUS' → 'AUTO'; add cruise_us, failsafe_ack, rc_age_ms,
    ch_*, gps_simulated, wp_set/lat/lon, captured, pid_*. New constants
    BATT_LOW_V=14.4 / BATT_CRIT_V=13.6 (4S LiPo conservative).
    - services/telemetryLogger: in-memory ring buffer (cap 7200 rows),
    CSV export via Share. Auto-starts on connect.
    - services/esp32Service: add setCruise + setSimGps; document which
    endpoints are implemented in test_29 vs production-firmware backlog.
    - MapScreen: full-width FAILSAFE banner with ACK_REQUIRED te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
    [test_29_pool_integration.ino]
2026-05-10 app: fix HelmScreen mode pill — AUTONOMOUS → AUTO
    types/index.ts dropped the legacy 'AUTONOMOUS' mode name when it was
    aligned to test_29; HelmScreen still compared against it, which
    TypeScript flagged as a no-overlap union check. The pill never lit up
    green in AUTO. Swap to the current name so the highlight works.
2026-05-10 app: production cleanup — strip non-functional screens, helpers, types
    Sweeping pass to remove things the app shouldn't ship. Production
    forever, not pool-test scoped.
    Screens
    remove FPVScreen — no camera module on this build
    remove SystemsScreen — anchors + bay doors aren't on this hull
    Helm — drop dead "Throttle + Rudder (Phase 1)" placeholder, add LIGHTS
    section (NAV/BRIDGE/DECK toggles lifted from SystemsScreen), expand
    nav row to [Map, Telemetry, Weapons, Survey, Settings]
    Weapons — strip to title + "controls land when firmware is ready"
    caption; all anim/audio/CIWS/gun buttons were 404 stubs
    Settings — held as placeholder: visual scaffolding stays, ba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
2026-05-10 app: explicit logging on/off + Helm BATT threshold colors
    Logging is now opt-in. ConnectionScreen no longer auto-starts the
    logger; TelemetryScreen gains a ▶ START / ■ STOP button next to the
    existing CLEAR / EXPORT pair, and HelmScreen shows a green "● LOG" pill
    in the status row while recording so the operator can confirm at a
    glance from the home screen.
    telemetryLogger gains isRunning() + subscribeRunning() so any screen
    can mirror the running state, alongside the existing count
    subscription.
    Helm BATT readout now uses the same client-side threshold logic as
    TelemetryScreen (BATT_LOW_V / BATT_CRIT_V) instead of relying on a
    `batt_low` boolean that test_29 never sends. Readout's o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
2026-05-10 app: Helm AUTOPILOT section, optimistic light toggles, BATT always renders
    Helm gains an AUTOPILOT section between the readout row and LIGHTS:
    CRUISE card — tappable, opens the same cruise preset modal as Map
    WP DIST card — shows wp_dist_m when a waypoint is set and GPS is
    locked, else '--'
    CruiseModal extracted to src/components/CruiseModal.tsx so Helm and
    Map share one implementation; MapScreen now imports it.
    Light buttons get optimistic local state so taps visibly toggle the
    button on/off regardless of whether /led 404s or echoes. test_29
    doesn't send nav_on/bridge_on/deck_on, so without this the buttons
    appeared dead. When production firmware adds the echo, replace the
    loc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
2026-05-11 app: Helm redesign + SYSTEMS hub (sectioned page)
    Helm rebuilt as a bridge-instrumentation layout:
    - Header: LEGEND CUTTER wordmark + USCG racing-stripe accent
    (red-white-blue, 4px tall, 120px wide) + colored mode chip
    (MANUAL=accent, AUTO=success, FAILSAFE=danger).
    - State sub-row: ● CONN ● LOG + computed English status sentence
    ("AT REST · MANUAL CONTROL" / "UNDERWAY · 0.3 KTS" / "AUTO ·
    TRACKING WP · 168.6 M" / "AUTO · NO WAYPOINT" / "FAILSAFE ·
    ACK_REQUIRED" etc).
    - Bilge alarm row (conditional, danger pill).
    - Primary readouts: 1×4 HEADING / SPEED / DEPTH / BATT with bigger
    monospace digits, separate unit, optional secondary line (BATT
    show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
2026-05-11 app: redesign Connection / Telemetry / Map to match Helm aesthetic
    Same bridge-instrumentation language as Helm: monospace digits, 4px hard
    radii, hairline rule dividers for sections, USCG stripe accent on the
    Connection brand moment.
    ConnectionScreen
    - Wordmark scaled up (26 / letter-spacing 6) with the same red-white-
    blue stripe under it as the Helm header — this is the brand moment.
    - Console-style status block ("> Probing known addresses…",
    "> Connecting…", "> Connection failed — verify IP and retry") with
    a left-edge accent rail. Replaces the prior plain text status.
    - Last-IP hint becomes a tappable "↺ last connected: x.x.x.x" so a
    bad edit can revert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
2026-05-12 app: round-1 UX refinements across all four screens
    Connection
    - Tap-outside-input now dismisses the iOS number pad (Pressable
    wraps the screen; TextInput also takes returnKeyType=done so the
    keyboard's submit dismisses too). Fixes a dead-end where the
    numeric keypad had no accessory to close it.
    - Drop the idle "Ready, confirm boat is powered…" message — the
    console block only renders during scanning/connecting/failed now.
    Power-on/wifi state is obvious enough without a banner saying so.
    - Manual IP entry moves under an ADVANCED disclosure (collapsed by
    default). SCAN becomes the full-width primary action; CONNECT and
    the last-IP hint live inside the ad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
2026-05-12 app: round-2 UX refinements (Map / Telemetry / Home)
    Map
    - HUD has three states: hidden (fix + no waypoint — the boat marker
    speaks for itself), minimal yellow "⚠ NO GPS FIX" (no card chrome),
    and the full bordered card (tracking or captured). Replaces the
    "POSITION ACQUIRED" big card that appeared every time the user
    just wanted to see the map.
    - Waypoint state rehydrates from telemetry on remount. If firmware
    reports wp_set with lat/lon, the local screen state mirrors that
    and the reticle redraws — fixes the "leave Map, come back, marker
    gone" bug. Also reflects local waypoint state into the WebView
    via a dedicated effect so the marker stays in syn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
2026-05-12 app: haptics on key actions + flip WP/trail colors
    Map colors
    - Waypoint reticle and planned-path polyline now use bright cyan
    (#00bfff — the app accent) instead of warning-yellow. The reticle
    grows slightly (28→30px, 2→2.5px ring) and the inner dot picks
    up its own glow, so the target reads as the most important thing
    on the map.
    - Boat trail shifts from cyan to a muted steel blue (#3a6db8, 0.75
    opacity). The trail is history — it shouldn't compete with the
    live target — and a desaturated color is clearly distinct from
    the bright path-line at a glance.
    - Net effect: WP + planned path = bright "where we're going",
    trail = dim "where we've been"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
2026-05-12 app: fix CLEAR WP race — rehydrate from telemetry once per mount
    Round-2 added telemetry-driven waypoint rehydration so the marker
    survives leaving and returning to Map. But its useEffect ran every
    time data.wp_set / data.wp_lat / data.wp_lon / waypoint changed, which
    meant a CLEAR-WP tap could be visually undone by the next stale
    telemetry frame: local state goes null, but the firmware hasn't yet
    processed the POST /waypoint clear, so /telemetry still reports wp_set
    true and the effect re-creates the marker. Looked intermittent because
    it depended on poll timing.
    Make rehydration one-shot per mount. A ref locks after the first
    successful hydrate, and also locks the moment the user takes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
2026-05-13 firmware: bilge MOSFET pin fix + /led handler in test_29
    [bilge.h, config.h, test_29_pool_integration.ino]
2026-05-14 test_29 + app: wire /audio endpoint to HelmScreen sound buttons
2026-05-16 test_29: GPS↔DF1201S UART swap (DF1201S on HW UART2, GPS on SoftSerial)
    DF1201S needs 115200 baud and SoftwareSerial-at-115200 was unreliable
    on ESP32 with WiFi active — begin() always timed out, so /audio
    returned 503. Putting DF1201S on HardwareSerial(2) (test_11's proven
    path) and moving GPS to SoftwareSerial @ 9600 (well within library
    limits) gets all four serial peripherals working. Bench-confirmed:
    audio plays on every HelmScreen sound tap, GPS still gets a fix, LEDs
    toggle. Pool run still pending.
    Also adds an unrun DF1201S recovery sketch as a future diagnostic if
    the module ever gets stuck in the persisted SINGLECYCLE auto-loop
    state we hit on 2026-05-16 (resolved by USB-direc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
    [test_29_pool_integration.ino]
2026-05-17 app + test_29: 3-zone bilge — damage-control panel + /bilge endpoint
    Firmware: BILGE_FWD/MID/REAR sensors on GPIO 32/33/5, auto-pump loop
    (on while wet + 5 s dry-delay), /bilge {on:bool} manual override with
    60 s safety auto-clear. App: types/service updated, helm alarm ORs
    all three + compact BILGE x/3 summary card linking to Systems,
    telemetry shows three rows + AUTO/MANUAL pump state. SystemsScreen
    replaces 3-cell grid with BoatDamagePanel — side-profile hull SVG
    (cleaned, script-stripped from file.svg) with three vertical thirds
    that fill red when wet; long-press to enter sim mode for previewing
    without dunking sensors. Adds react-native-svg.
    [test_29_pool_integration.ino]
2026-05-18 test_29 + app: add /radar endpoint and Systems toggle
    Mast TRS-3D radar dish on GPIO 2 via 2N2222 NPN transistor. Constant-speed
    on/off, no PWM. Telemetry exposes radar_on. RADAR section added to
    SystemsScreen between BILGE and WEAPONS. Supersedes the prior PCA9685 ch7
    / GPIO 13 MOSFET designs from the production scaffold.
2026-05-18 remove empty radar.md — Ryan's scratch file, accidentally committed
2026-05-18 test_29 + app: radar speed control via PWM (LEDC)
    Switches GPIO 2 radar motor from digitalWrite to LEDC PWM @ 20 kHz, 8-bit
    resolution. /radar accepts {on?, speed?:0..100} — either field optional,
    unsent fields keep prior state. SystemsScreen replaces single toggle with
    OFF/25/50/75/100% preset row. Telemetry adds radar_speed.
    KNOWN HARDWARE GAP: no flyback diode across the motor yet. Back-EMF from
    PWM switching will degrade the 2N2222 over time. Operator (Ryan) is
    shipping without diode for pool prep — needs 1N4148/1N4001 anti-parallel
    across motor before sustained use. Documented in NOTES.md and inline.
    [test_29_pool_integration.ino]
2026-05-19 test_29: fix LEDC API for ESP32 Arduino core 3.x
    Core 3.x replaces ledcSetup() + ledcAttachPin() + ledcWrite(channel,…)
    with pin-based ledcAttach(pin, freq, res) + ledcWrite(pin, duty). No
    more manual channel allocation.
    [test_29_pool_integration.ino]
2026-05-19 test_29: drop radar PWM to 1 kHz for usable low-speed torque
    20 kHz pulses were too short for motor coil current to build per pulse,
    so low duty cycles produced almost no torque (25% didn't spin, 50% was
    already fast). 1 kHz gives 250 µs ON pulses at 25% — current reaches
    steady-state, torque scales with duty as expected. Tradeoff: audible
    PWM whine, acceptable for cosmetic radar.
    [test_29_pool_integration.ino]
2026-05-20 test_29 + app: burst-mode defaults 10/200 ms + live-tunable burst/pause [UNTESTED]
    Original burst defaults (100 ms / 1500 ms) were sized for a slow motor
    and produced 'crazy fast' rotation on Ryan's actual ~150 RPM rated
    geared motor. New defaults: 10 ms burst / 200 ms pause — should give
    ~9° step per burst at 150 RPM, ~5 steps/sec average ≈ 7 RPM radar-look
    rotation if the motor's true unloaded speed is close to spec.
    Also exposes burst_ms (2..5000) and pause_ms (0..60000) via /radar so
    the burst cadence can be tuned live from curl / future app sliders
    without reflashing.
    UNTESTED. Could fail in two ways:
    1. Motor doesn't reliably start a 10 ms burst from cold (stiction
    wins).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
    [test_29_pool_integration.ino]
2026-05-20 test_29 + app: radar burst-only, torque presets
    Removes smooth-PWM mode entirely (no app UI, no firmware code path,
    no /radar mode param, no radar_mode telemetry). Was a dead end at
    this motor's actual speed (~2000 RPM peak makes smooth at any duty
    look like a propeller).
    App's 4 speed presets become full torque tuples:
    25% → speed=25, burst_ms=3, pause_ms=200 (TESTED GOOD 2026-05-20)
    50% → speed=50, burst_ms=2, pause_ms=200 (untested, more authority)
    75% → speed=75, burst_ms=2, pause_ms=200 (untested)
    100% → speed=100, burst_ms=2, pause_ms=200 (untested, max torque)
    Higher presets give the motor more authority to overcome stiction at
    the cost of slightly faster apparent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
2026-05-21 test_29 + app: JSN-SR04T depth sensor with /depth endpoint
    Firmware: pulseIn-based ping on TRIG=27 / ECHO=14. /depth POST
    {mode:stop|check|run}. RUN polls every 20s, CHECK fires a one-shot
    (mode unchanged), STOP halts polling AND clears the stored reading.
    40 ms worst-case pulseIn timeout — negligible impact on iBUS/IMU at
    ≤1 ping per 20s. Telemetry exposes depth_m, depth_mode, depth_age_ms
    (absent depth_m after STOP).
    App: setDepth() helper, TelemetryData extended. New DEPTH section on
    SystemsScreen with big readout + STOP/CHECK/RUN buttons. HelmScreen's
    existing DEPTH readout fixed to gate on depth_m instead of the absent
    sonar_ok flag.
    [test_29_pool_integration.ino]
2026-05-21 test_29 + app: fix depth — RCWL-1655 (not JSN-SR04T) + freshwater sound speed
    Per test_04 NOTES water-deployment checklist:
    - Sensor is RCWL-1655, NOT JSN-SR04T (different family, non-standard pin
    labels TRIG_RX_SCL_I/O and ECHO_TX_SDA on the board silkscreen).
    - Sound-speed conversion was using the AIR constant (5831 µs/m); fixed
    to freshwater (13.4 µs/cm → 1340 µs/m). Production config.h already
    has SONAR_SOUND_SPEED_US_CM=13.4 for the same reason.
    - Range corrected to 2-450 cm.
    - ECHO pin now INPUT_PULLDOWN per test_04 debug note.
    Side effect: bench-air tests will now read ~4.3× too large (30 cm wall
    → ~130 cm) because we're applying the water constant. Pool readings
    will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
    [test_29_pool_integration.ino]
2026-05-21 test_29 + app: bilge run-dry protection (BILGE_MAX_RUN_MS)
    Production legend_cutter/bilge.cpp has a 60 s emergency cutoff if the
    pump runs continuously without ever seeing a dry reading — guards
    against stuck-wet sensors (corroded probe, broken wire shorted to GND,
    debris bridging the screws permanently) running the pump until the
    battery dies or the pump burns out dry.
    Port to test_29:
    - Track pumpOnSinceMs when the pump transitions off → on
    - After 60 s continuous run with no dry reading, latch auto-pump off
    and force pump off. Latch only clears when sensors actually go dry
    (one real LOW→HIGH transition).
    - Manual /bilge {on:true} still works as an escape hatch — operator
    ca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
    [test_29_pool_integration.ino]
2026-05-22 test_29 + app: perpendicular-crossing capture trigger
    Existing distance trigger (wp_dist < 3 m) doesn't help when GPS noise
    is ~2-3 m and the boat circles the waypoint without quite crossing
    the perimeter. Add a secondary trigger: capture fires when the boat
    crosses the perpendicular line through the waypoint, drawn perpendicular
    to the start→waypoint leg.
    Whichever fires first wins. Capture radius default (3 m) unchanged.
    Waypoint data structure unchanged. GPS/IMU integration unchanged.
    Implementation:
    - startLat/startLon/startValid recorded on first GPS fix after
    /waypoint is POSTed (or after clear→re-set). Cleared when waypoint
    changes or is cleared.
    - hasCrossedTarget() project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
    [test_29_pool_integration.ino]
2026-05-23 test_29: path-based DF1201S audio (horn/gun wired)
    - /audio now dispatches on req["sound"]: horn → /cutter-horn.mp3,
    gun → /deck-gun.mp3 via playSpecFile() (AT+PLAYFILE).
    - board falls back to internal-flash track 1 (no clip yet).
    - Repo source-of-truth: audio-assets/dfplayer/. Path-based playback
    is immune to DF1201S write-order/phantom-flash issues, so loading
    the device is just a Finder drop.
    - NOTES updated.
    [test_29_pool_integration.ino]
2026-05-23 test_29: wire board.mp3 (all 3 sound buttons now path-based)
2026-05-23 test_29: DF1201S paths to /SFX/<8.3>.MP3 (was misdirecting)
    Long-filename paths at root (e.g. /cutter-horn.mp3) resolved
    unreliably on the DF1201S firmware — on first water test, horn
    silently played the board clip. EF only ever proved path playback
    with /SFX/EDMUND.MP3 (subfolder + 8.3 uppercase), so match that
    exact pattern: HORN.MP3 / GUN.MP3 / BOARD.MP3 under /SFX/.
    Reload procedure: mount the DF1201S as USB, delete the old root
    mp3s, drag audio-assets/dfplayer/SFX/ to the device root.
    [test_29_pool_integration.ino]
2026-05-23 test_29: switch to index-based DF1201S audio (path-based abandoned)
    DFRobot Issue #5 documents that AT+PLAYFILE silently falls back to
    file 1 on any path mis-resolution (filename-length quirks, macOS
    metadata, etc.) — which is exactly what bit us on the first water
    test (all 3 buttons played BOARD because it was at index 1 on the
    device after a Finder drag of /SFX/). Switching to playFileNum
    (AT+PLAYNUM) sidesteps the path parser entirely; this is what EF
    actually shipped on (commits 6353ed9, 54b67fb).
    - Firmware: handleAudio() now dispatches via playFileNum(1/2/3).
    - audio-assets/dfplayer/load.sh: wipes the DF1201S, copies HORN
    → GUN → BOARD one-at-a-time with cp -X + dot_clean, ej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
    [test_29_pool_integration.ino]
2026-05-23 test_29: port MANUAL reverse from test_17 (CH2 + interlock)
    Reverse was missing — CH2 was unused, setEscs() clamped its floor at
    NEUTRAL_US blocking any reverse output. Ported test_17's pattern:
    - IBUS_IDX_REVERSE = 1, REVERSE_DEADBAND_US = 30
    - computeThrottleUs(left, rightV) with interlock: forward throttle
    ALWAYS wins; reverse only engages when left stick is at idle. Can't
    slam forward→reverse.
    - MIN_REV_US = 1200 (~60% reverse cap)
    - setEscs() floor widened to MIN_REV_US (callers in AUTO/FAILSAFE
    still pass values ≥ NEUTRAL_US, verified)
    - ch_reverse exposed in telemetry for visibility
    - Old mapThrottleStickToEsc helper removed (unused)
    AUTO mode unchanged — cruise/heading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
    [test_29_pool_integration.ino]
2026-05-23 untrack todo.md + remove WiFi AP fallback
    - todo.md → .gitignore + git rm --cached (Ryan's personal pool prep list,
    accidentally added in the reverse-port commit). File stays on disk.
    - WiFi: drop AP fallback. Home then hotspot, then continue without
    HTTP if both fail. Autopilot + RC failsafe are independent of WiFi
    so no safety impact. The AP-mode escape hatch was unused and added
    another mode the operator had to think about.
    [test_29_pool_integration.ino]
2026-05-23 test_29: pause() before playFileNum() — fix gun-plays-horn race
    EF commit 54dc3ca documented this exact bug: playFileNum() called
    while a previous track is still playing gets silently dropped by
    the DF1201S. Symptom on first water test: pressing the gun button
    within HORN.MP3's 2.35s duration left horn playing and silently
    dropped the gun command — user perceived it as "gun plays horn".
    Board worked because users pressed it later, after horn finished.
    Fix matches EF's: DF1201S.pause() + 50ms before each playFileNum().
    [test_29_pool_integration.ino]
2026-05-23 test_29: add /audio_diag — query the DF1201S for its actual index map
    DIAGNOSTIC ONLY — remove after the index→filename truth is known.
    Per EF commit 6353ed9, the DF1201S can have phantom files in internal
    flash that shift the user-file indices, and SINGLE play mode must be
    forced before each playFileNum to avoid auto-advance. This endpoint
    applies that pattern to every index 1..8, then queries the chip
    (getCurFileNumber + getFileName + getTotalTime) and returns the
    results so we can see — not guess — what the device actually has at
    each index.
    Also instruments handleAudio() to log + return the chip's actual
    selected file after every press. JSON resp[] now includes
    "actual_num" +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
    [test_29_pool_integration.ino]
2026-05-23 test_29: index map 1/3/5 per /audio_diag (macOS resource forks)
    /audio_diag confirmed the DF1201S has 22 files: 3 real MP3s, 3
    invisible macOS AppleDouble companions (._HORN.MP3 etc) created by
    Finder during the drag, and 16 leftover EF voice files. Real files
    landed at odd indices because the companions occupy the evens.
    Temporary fix — once the device is wiped + reloaded without
    AppleDouble files, indices revert to 1/2/3.
    [test_29_pool_integration.ino]
2026-05-24 audio: document everything we learned + drop /audio_diag
    Sound effects verified working on the boat (horn / board / gun all
    play the correct clip). Putting the diagnostic away and writing
    down the surprises so future-us doesn't repeat the day:
    - audio-assets/dfplayer/NOTES.md — the full story. Hardware identity
    (Pro vs Mini), how playback works (FAT write order, not filename),
    the four gotchas (macOS AppleDouble companions, internal-flash
    hoarding, DFRobot Issue #5 path-playback bugs, pause-before-play
    race), the clean reload procedure, and the diagnostic snippet
    ready to paste back if anything breaks again.
    - test_29: remove the /audio_diag endpoint and the diagnostic fields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
    [test_29_pool_integration.ino]
2026-05-24 test_29: add differential thrust to AUTO mode (factor=0.3, matches test_17/motors.cpp)
2026-05-24 test_29: clear gpsValid on stale fix so AUTO safe-holds on GPS loss
    [test_29_pool_integration.ino]
2026-05-24 test_29: bilge pump triggered by mid sensor only (fwd/rear are informational)
2026-05-24 legend_cutter: port water-tested firmware from test_29
    Replaces the original speculative firmware (which was written before any
    hardware existed) with a modular 1:1 port of test_29_pool_integration —
    plus deck-gun pan from test_18. Stripped CIWS, anchor winch, bay doors,
    OTA, NVS, RTH, e-stop, and AP-only WiFi — none of those have a passing
    gate yet and will return when each subsystem is water-tested.
    Module layout (mirrors the original):
    config.h channel map locked 2026-05-10; all pins/bounds from test_29
    ibus UART1 parser
    motors PCA9685 ESCs + rudder, reverse interlock, diff thrust
    imu ICM-20948 + complementary filter + PD heading-hold (live gains)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
    [audio.cpp, audio.h, battery.cpp, battery.h, bilge.cpp, bilge.h, config.h, gps.cpp]
2026-05-24 test_29: port Edmund Fitz scan-based WiFi connect for hotspot reliability
    Blind WiFi.begin() failed to connect to iPhone hotspot in the field.
    Replaced with scan-first connect (matches any SSID containing 'iPhone'
    to survive curly-vs-straight apostrophe and phone renames), bumped
    connect timeout to 20s, and added 30s re-scan loop on disconnect.
    [test_29_pool_integration.ino]
2026-05-25 app: helm spacing + map back-button moved to bottom-left
    - HelmScreen: 24 px breathing room below the BILGE card so it doesn't
    jam into the LIGHTS section.
    - MapScreen: ‹ HELM moved out of the top bar to a rounded pill at the
    bottom-left, mirroring the center-on-boat FAB. Bigger tap target and
    reachable one-handed without resetting the map position. MODE chip
    stays at the top.
    Also removes the stale FIRMWARE_AUDIT.md — superseded by the wholesale
    port of test_29 into legend_cutter/.
2026-05-28 bilge: rear-driven, 6s/6s duty cycles, auto cap 60s + manual until stopped
    Pump moved from the mid to the rear compartment, so the only sensor that
    drives auto-pump is bilge_rear (fwd/mid stay informational). Replaces
    the always-on + dry-delay tail with an explicit 6 s ON / 6 s PAUSE
    state machine:
    AUTO — engages on rear-wet, gives up after 60 s total elapsed if
    the rear probe is still wet. Sets a stuck latch; auto stays
    off until rear actually reads dry once.
    MANUAL — operator-engaged via POST /bilge {on:true}, cycles forever
    until POST /bilge {on:false}. Clears the stuck latch.
    Telemetry adds pump_phase ("off"|"on"|"pause"), pump_cycle (1-based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
    [bilge.cpp, bilge.h, config.h, telemetry.cpp, test_29_pool_integration.ino]
2026-05-29 app: bump buildNumber to 2, enable EAS autoIncrement; test_29: fix BilgePhase enum forward-decl order
    [test_29_pool_integration.ino]
2026-05-30 legend_cutter: invert ESC direction, trim throttle 30% after 2026-05-29 pool run
    Forward stick was driving props in reverse — mirror at the PCA write
    boundary via ESC_DIRECTION_INVERTED so MAX_FWD_US still means "forward
    fast" upstream and diff thrust polarity is preserved. Top end was also
    problematically fast at the prior 60% cap; trim to ~42% (MAX_FWD_US
    1800→1710, MIN_REV_US 1200→1290) with AUTO cruise cap/default brought
    down to match.
    [config.h, motors.cpp]
2026-05-30 legend_cutter: expose session_id in /telemetry
    App uses session_id to detect mid-flight reboots so the flight logger
    can finalize the prior flight before starting a new one. Generated once
    per boot via esp_random(). JSON doc + output buffer bumped 1280→1536
    to keep headroom.
    [telemetry.cpp]
2026-05-30 app: auto-start/stop flight logger, FlightsScreen for saved runs
    Logger now self-arms when the boat is throttled up (|esc_us - 1500| > 30
    for 500 ms) and self-saves on telemetry loss (60 s), firmware
    session_id change (mid-flight reboot), or manual STOP. Each flight
    persists to AsyncStorage as flight:<isoTimestamp> + a flights:index
    metadata list. New FlightsScreen lists saved flights with tap-to-share
    and long-press/× to delete; entry button lives in SystemsScreen.
    Manual TelemetryScreen START/STOP/CLEAR still work as before.
    See FLIGHT_LOG_PLAN.md (gitignored) for the design.
2026-05-30 legend_cutter: bump FIRMWARE_VERSION to 0.3.0-pool2
    Marks the post-2026-05-29 firmware (inverted ESCs, 30% throttle trim,
    session_id field) so the app's Firmware row makes it obvious which
    build is on the boat. If telemetry still shows "test_29" you've flashed
    the test sketch by mistake — open firmware/legend_cutter/legend_cutter.ino.
    [config.h]
2026-05-30 test_29: port pool-2 firmware fixes (ESC inversion, throttle trim, session_id, version)
    I previously applied these changes to firmware/legend_cutter/ on the
    assumption it was the production firmware (per CLAUDE.md). It's not —
    test_29 is what's flashed to the boat for pool runs. Mirroring the
    same set of changes here:
    - ESC_DIRECTION_INVERTED + escUs() helper applied at writePCA boundary
    so forward stick drives props forward.
    - Throttle trimmed ~30%: MAX_FWD_US 1800→1710, MIN_REV_US 1200→1290,
    AUTO_CRUISE_CAP_US 1750→1700, DEFAULT_CRUISE_US 1660→1620.
    - session_id (esp_random()) added to /telemetry so the app's flight
    logger can detect mid-flight reboots.
    - Firmware version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
    [test_29_pool_integration.ino]
2026-05-30 test_29 NOTES: pool run #2 2026-05-30 PASS, lake test next
    ESC direction fix, throttle trim (1710/1290/1700/1620), session_id all
    validated in water. Boat drives well, AUTO engages and yaws correctly
    toward waypoint. One open finding: IMU heading reads ~20° leftward of
    intended bearing under AUTO; consistent across two directions, so
    likely a magnetometer calibration issue not a nav-math bug. Pool too
    small for GPS+IMU fusion to nudge it. Pre-lake checklist captured.
2026-05-30 gitignore: add CALIBRATION_PLAN.md (matches FLIGHT_LOG_PLAN, AUTOPILOT_PLAN convention)
2026-05-30 test_30_mag_calibration: app-triggered, NVS-persisted mag cal scaffold
    Proves the plumbing test_29 will inherit for in-field recalibration
    without reflashing:
    - Plateau-detect cal procedure (ported from test_22) runs onboard when
    triggered via POST /calibrate_mag/start, not at boot.
    - Hard-iron offsets persist in ESP32 NVS namespace `imu_cal`, loaded
    at boot, survive power cycles.
    - Heading math matches test_29 exactly (raw-mag offset subtraction,
    then test_29's axis remap + tilt comp) so cal values port cleanly.
    - /telemetry exposes mag_cal_state, mag_cal_progress, offsets,
    baseline_uT, magnitude — enough for an app to drive the UX without
    any client-side math.
    Gates 6 + 7 (hea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
2026-05-30 revert test_30 sketch: no separate bench rig exists for component-level isolation
    The test_30 scaffold assumed a spare ESP32 + ICM-20948 on a breadboard
    that doesn't exist — the boat is sealed and assembled. Pivoting to
    integrate NVS-based mag calibration directly into test_29 with safe
    defaults (NVS empty → use existing hardcoded MAG_OFFSET_* values), so
    flashing the new test_29 has zero behavior change pre-cal.
    Risk is contained: cal additions are isolated to the IMU code path
    and the NVS namespace `imu_cal`. No FSM, motor, or GPS changes.
2026-05-30 test_29: app-triggered mag calibration with NVS persistence
    Adds in-field recalibration without reflashing — operator POSTs
    /calibrate_mag/start, rotates the whole boat through 360°, plateau
    detection captures min/max per axis, computes hard-iron offsets,
    saves to NVS namespace `imu_cal`, applies to live heading. Survives
    power cycles (loaded at boot via Preferences). 60 s timeout, abort
    endpoint, fail-with-reason state.
    Safe default: NVS empty → falls back to existing hardcoded
    DEFAULT_MAG_OFFSET_* values (the same -20.70/-0.45/-17.70 that were
    in effect before). Flashing this firmware produces zero behaviour
    change pre-cal — only triggering /calibrate_mag/start activates the
    new pa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
    [test_29_pool_integration.ino]
2026-05-31 app: CalibrationScreen + HelmScreen banner + Telemetry Mag row
    New CalibrationScreen drives the firmware's onboard mag cal procedure
    (test_29-pool2.1-magcal endpoints). State-machine UI:
    - idle/done: shows current offsets + baseline, START/RECALIBRATE button
    - collecting: rotation instructions + progress bar + live magnitude + ABORT
    - failed: fail reason + RETRY
    All math stays on the boat; app is a remote trigger + status display.
    Wired the previously-disabled "CALIBRATE IMU COMPASS" button in
    SystemsScreen to navigate into the new screen.
    HelmScreen status banner now surfaces compass health:
    - "COMPASS NOT CALIBRATED" (warning) when firmware reports
    mag_calibrated=false
    - "COMPASS DRIFT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
2026-06-05 test_29: diff thrust mix applied in MANUAL too (was AUTO-only)
    Routes MANUAL through the same computePortStbd + setEscsPortStbd path
    as AUTO, using DIFF_THRUST_FACTOR=0.3. AUTO call site unchanged.
    Motivated by a broken left rudder before the St. Michaels harbor test
    — inner-motor slowdown preserves turning authority on the broken side.
    Untested in water; first real-world run is the harbor trip.
    [test_29_pool_integration.ino]
2026-06-05 app: flight log map view, lifetime stats, FS-backed CSV storage
    Move per-flight CSV bodies from AsyncStorage to expo-file-system —
    durable against Expo Go sandbox resets and the 6 MB AsyncStorage
    soft cap. FlightMeta gains derived stats (distance, max speed,
    mode-time mix, batt start/end, max depth, capture flag), aggregated
    into a LIFETIME card on the list and a per-flight stats panel +
    Leaflet polyline of the GPS track on a new FlightDetailScreen.
    Share uses expo-sharing (real .csv file attachment, not message
    body). FLIGHT LOGS button on ConnectionScreen so logs are reachable
    without connecting to a boat. Legacy AsyncStorage flights migrate
    lazily on first list/open.
2026-06-05 app: satellite tile layer toggle on Map + FlightDetail
    Esri World Imagery (keyless) added alongside OpenStreetMap on both
    map WebViews, defaulting to satellite. Corner MAP/SAT button swaps
    layers. Better visual context for placing waypoints near piers,
    shoreline, and other features that street tiles don't render.
2026-06-07 test_29: bump MAX_FWD_US to 1800 + version stamp (UNTESTED, in-field)
    Harbor test of test_29-pool2.1-magcal showed forward thrust very weak
    at MAX_FWD_US=1710 (max stick → PCA pulse ~1290 µs after inversion),
    while reverse braking was strong as expected (PCA pulse 1710 µs).
    Hypothesis: ESC's full-forward-thrust zone needs PCA pulses deeper
    than ~1290 µs; the 1710 cap was sitting right at the boundary,
    amplified by the small diff-thrust port/stbd asymmetry.
    Bumping MAX_FWD_US 1710 → 1800 (pool #1 level) gives ~90 µs more
    headroom into the ESC's full-thrust zone. MANUAL diff thrust kept
    (operator needs it for broken left rudder mid-trip). AUTO untouched.
    Version stamped `test_29-pool2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
    [test_29_pool_integration.ino]
2026-06-07 test_29: undo pool #2 throttle slowness across all paths (UNTESTED, in-field)
    Continues da91a87c. Restores remaining pool #1 caps so diff thrust has
    ~300 µs of headroom either side of neutral, well past the ESC's
    deadband/resistance threshold (the in-field root-cause hypothesis).
    - MIN_REV_US: 1290 → 1200 (symmetric reverse, pool #1 level)
    - AUTO_CRUISE_CAP_US: 1700 → 1800 (matches MAX_FWD_US; app can dial cruise high)
    - DEFAULT_CRUISE_US: 1620 → 1720 (boat-side fallback past the deadband, so
    AUTO has authority even if app POST /cruise
    is lost to WiFi)
    - Version stamped `test_29-pool2.4-uncap`.
    ESC_DI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
    [test_29_pool_integration.ino]
2026-06-09 mission_logs: standalone viewer with playback, soundings, screen-record
    Drag a CSV onto mission_logs/viewer/index.html and replay the run:
    Leaflet map with growing track, depth-colored sonar pings, rotating
    boat icon, waypoint + capture flash, HUD overlay, MAP/SAT toggle,
    depth-over-time strip chart, play/pause/scrubber/speed chips, and a
    REC button that captures the tab to webm via MediaRecorder.
    Also commits the in-tree mission log CSVs and the static prototype
    example.html they came from.
    [2026-06-05T15-26-05.csv, 2026-06-05T15-39-51.csv]
2026-06-11 test_29: WiFi reconnect is non-blocking — AUTO runs on RC+GPS, never pauses for WiFi (UNTESTED)
2026-06-11 test_29 + app: remove /sim_gps entirely — bench-only crutch, dangerous if hit in water
2026-06-11 test_29: reject waypoints >1000 m from the boat (fat-finger guard, checked at POST and at first fix)
    [test_29_pool_integration.ino]
2026-06-11 test_29: compute heading-hold D-term at IMU cadence — loop-rate sampling gave spiky ~10x-inflated dErr (UNTESTED)
2026-06-11 test_29: capture detection arms only in AUTO; leg start recorded at AUTO engage, not /waypoint POST (UNTESTED)
2026-06-11 test_29: fix stale 1700/1710 cap text in SAFETY header and /cruise error — docs now match the 1800 uncap, zero behavior change
    [test_29_pool_integration.ino]
2026-06-11 test_29: NOTES for pool2.5 autonomy-review fixes + bench gates; bump version string
    [test_29_pool_integration.ino]
2026-06-13 test_29: mag-cal rework (coverage-based, horizontal axes) + declination + GPS-COG trim (UNTESTED)
    Root cause from 2026-06-05 harbor log: 42° one-cycle deviation from a bad
    hard-iron cal plus ~11°W declination never applied; motor/ESC field is
    minor (~2 µT). Old cal gated plateau on chip X — the VERTICAL axis — and
    never validated chip Z.
    - Cal finishes on 12-sector rotation coverage of the horizontal (Y/Z)
    field circle; progress = sectors covered, not elapsed time. Spike
    filter, center re-bin, specific fail reasons, 90 s timeout.
    - Post-cal quality verdict (good/fair/poor) vs expected ~20.5 µT local
    horizontal field; radius/circularity persisted to NVS and in telemetry.
    mag_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
    [test_29_pool_integration.ino]
2026-06-13 app: CalibrationScreen coverage ring + quality results card; COG trim row
    - Collecting view shows the firmware's 12-sector coverage bitmap as a
    ring of dots that only light when the boat actually rotates — replaces
    the range-based bar that read like a countdown.
    - Post-cal results card: GOOD/FAIR/POOR verdict, field radius vs the
    expected ~20.5 µT, lopsidedness %, plain-language interpretation, and
    a verify-against-phone-compass hint (TRUE north).
    - Idle view shows true heading + live vs expected |B|; instructions
    rewritten for the in-water procedure.
    - TelemetryScreen shows COG trim when nonzero; types add heading_mag,
    cog_trim, mag_cal_mask/quality/radius/circ.
2026-06-14 test_29: telemetry buffer 1536→2048 + near-limit WARN; nav-light WiFi boot signal (UNTESTED)
2026-06-14 test_29 pool2.6-magcal2: PASS — first autonomous waypoint capture
    Water test 2026-06-14 (4 mission logs). Heading root cause fixed:
    true-heading/declination live (+10-12 deg ~= local declination),
    heading tracks GPS course underway (median |err| ~6.6 deg vs 36 deg
    on the 06-05 log), cal GOOD from NVS (radius 22.5uT), cog_trim
    converged within +/-2 deg. AUTO drove to a waypoint and captured
    by distance (twice). SwD failsafe + bilge auto-pump confirmed.
    Open for next test: PID under-damped (rudder reverses ~54% of
    samples, rails ~36%) -> smooth the AUTO steering. TX-off frame-loss
    failsafe still unproven; mag_cal_circ_pct not restored from NVS;
    batt_a reads 0.
    [2026-06-14T10-38-30.csv, 2026-06-14T10-43-21.csv, 2026-06-14T10-44-18.csv, 2026-06-14T10-53-08.csv]
2026-06-14 firmware: production port plan — test_29 -> legend_cutter cutover
    Planning doc for the one-time, complete, faithful port of the PASS'd
    test_29 firmware into the modular legend_cutter stack as the final
    firmware (semver from 0.4.0). Captures the cutover decision, accuracy
    prime directive (test_29 @ 7b0f7cdd = source of truth; prior ports
    were partial), guardrails, outcome-gated staged plan with
    agent-owned decomposition, and the agent kickoff brief.
2026-06-14 port plan: agent runs Stage 0->1 without pausing for sign-off
2026-06-14 firmware: finish porting test_29 capabilities into legend_cutter (v0.4.0)
    Brings the modular production firmware up to the PASS'd test_29-pool2.6-magcal2
    capability set, keeping the capabilities already ported from other passing
    tests (test_18 deck-gun turret).
    Newly ported from test_29:
    - imu: NVS-backed mag-cal FSM, true heading (declination + COG trim),
    IMU-cadence D-term; heading-hold now steers TRUE bearing.
    - navigation: MAX_WP_DIST_M guard + auto-clear; capture/leg-start gated to
    AUTO; leg-start reset on AUTO engage.
    - telemetry: app-consumed mag_*/heading_mag/cog_trim/failsafe_ack keys,
    2048 buffer, scan-first WiFi + non-blocking reconnect, /calibrate_mag routes.
    - config.h: t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
    [config.h, gps.cpp, gps.h, imu.cpp, imu.h, legend_cutter.ino, navigation.cpp, navigation.h]
2026-06-14 firmware/tools: static parity checker + read-only boat health check
    parity_check.py: contract diff (constants/keys/routes) + per-function
    computational-skeleton diff of legend_cutter vs test_29 — re-runnable proof
    the port still matches the source-of-truth sketch.
    check_boat.py: laptop-side, read-only /status + /telemetry validator (never
    POSTs) — confirms all expected keys present, values sane, telemetry live.
2026-06-16 firmware: onboard telemetry history ring + GET /history backfill (v0.5.0)
    New histlog module keeps a RAM ring of compact per-second records, recorded
    continuously regardless of WiFi state. GET /history?since_ms=<uptimeMs> serves
    the gap, paged via HISTLOG_PAGE_MAX, so the app can fill a WiFi dropout on
    reconnect. RAM-only by design (a reboot is already a flight boundary). Live
    /telemetry contract untouched; parity_check shows only the new /history route.
    [config.h, histlog.cpp, histlog.h, legend_cutter.ino, telemetry.cpp, telemetry.h]
2026-06-16 app: store-and-sync gap backfill + reboot-driven flight boundary
    Remove the 60s telemetry-loss flight-split. A flight now ends only on a boat
    reboot (session_id change), a 5 min unrecovered absence, or manual stop. On
    reconnect, a jump in the boat's uptime between frames triggers a /history
    backfill (new historyService.ts) that merges the missed records into the
    running flight, deduped by second and re-sorted by timestamp. Record uptime is
    mapped to wall-clock via the live anchor frame. Also records the shipped design
    in TELEMETRY_SYNC_IDEA.md.
2026-06-17 app: crash-safe draft checkpoint so a killed app doesn't lose the flight
    The in-progress flight lived only in RAM until finalize; an OS eviction before
    then lost it (and the 5 min gone-timeout widened that window). Mirror the buffer
    to flights/_draft.csv every 30 s on the existing tick, and recover any leftover
    draft into a real flight on next launch. Worst-case loss drops from the whole
    flight to ~30 s. Reuses existing file/CSV/stats helpers; no AppState hook.
2026-06-18 app: foreground-aware backfill so app-backgrounding (camera) doesn't lose data
    Switching away from the helm app freezes its poll timer, so it stops hearing the
    boat though the boat is fine. Add an AppState listener: on return to foreground,
    reset the boat-gone window, and only judge 'gone' while foregrounded — so a long
    app-switch can't be mistaken for the boat leaving and split the flight. The gap
    (depth included) backfills frame-driven on resume via the existing path. No new
    dependency (AppState is RN core).
2026-06-19 firmware: smooth AUTO steering — deadband + slew rate + lower Kp (v0.5.1)
    Kp 3.0→1.5: full rudder now requires 113° heading error (was 57°).
    5° heading deadband: suppresses P-term hunting near setpoint.
    85 µs/s rudder slew limit: 0→full deflection takes ~2 s, no instant
    full-rudder snaps. Slew state auto-resets to neutral when AUTO has
    been disengaged >500 ms, so each AUTO engage starts from neutral.
    Kd kept at 8.0 — it's the correct IMU-cadence turn-rate brake.
    [config.h, imu.cpp]
2026-06-26 site: initial project page
    1:96 Legend-class cutter showcase — hero with background image slot,
    capabilities grid (9 cards), hardware spec table, video and gallery
    media slots. Naval palette, USCG racing-stripe motif, Space Mono/Saira
    type stack.
2026-06-26 site: interactive waypoint + depth-mapping demos, de-slop pass
    - Restructure: hero (image slot, empty placeholder) → capabilities →
    nav sim → depth sim → hardware. Drop the failsafe focus, build log,
    staged-build, and "what it isn't" sections.
    - Add "How it holds a waypoint" — canvas sim of capture-by-distance.
    - Add "How it maps the bottom" — top-down waypoint survey painting a
    banded, contoured depth chart one sounding at a time.
    - Both sims are synthetic/labeled, respect prefers-reduced-motion.
2026-06-26 site: add 'who has control' + 'how it steers' demos
    - Mode arbitration (DOM): auto-playing MANUAL/AUTO/FAILSAFE scenario
    showing transmitter priority and link-loss failsafe latch.
    - Heading-hold steering (canvas): compass error -> twin-rudder
    deflection + differential thrust -> turn onto target bearing, with
    deadband + slewed rudder mirroring the firmware loop.
    - Fix steering copy to "twin rudders + differential thrust" (nav lede,
    hardware spec). Add "How it works" nav link; renumber sections 01-06.
2026-06-26 site: drop steering demo, move 'who has control' below mapping
    - Remove the "How it steers" section and its canvas.
    - Relocate "Who has control" to sit after the depth-mapping section.
    - Replace its text readout with a stylized transmitter graphic: SwA
    mode switch (AUTO/MANUAL), SwD failsafe guard, throttle/rudder sticks
    (Mode 2), and an RC-link indicator that drops out on failsafe.
    - Renumber sections 01-05; point "How it works" nav at the first demo.
2026-06-26 site: add playback controls to 'who has control'
    Prev/next arrows flank the demo to step through the MANUAL/AUTO/
    FAILSAFE scenario manually; a play/pause button (top right) toggles the
    auto-procession. Stepping resets the auto-timer; paused state redraws
    the transmitter on manual steps. Respects prefers-reduced-motion
    (starts paused, no auto-advance).
2026-06-27 site: make 'who has control' interactive — clickable SwA/SwD + mode cards, arrows further out
2026-06-27 firmware: STA WiFi range/reliability tuning (v0.5.2)
    Disable modem power-save, max TX power, keep 11b long-range basic rates,
    pin 20MHz HT20 — on the STA link only (telemetry/command; no control or
    FSM change). Re-asserted on each (re)connect since association can reset
    power-save/TX-power; logs TX power before/after.
    Channel stays router-side (a STA follows the AP). Boat runs STA, not AP,
    so wifi-task.md's AP-mode framing is adapted to WIFI_IF_STA.
    [config.h, telemetry.cpp]
2026-06-27 app: backfill retries until the gap fills — no more lost telemetry
    Replace the fire-and-forget /history fetch (whose swallowed failure lost
    the whole gap permanently) with a queued, sequentially-pumped backfill
    retried every frame and every 5s tick until the link is usable again.
    Gaps are dropped only on reboot (ring cleared) or flight end; overlapping
    gaps on choppy links are queued, not discarded. Surfaces the real fetch
    error with cursor + attempt count. Adds pendingGapCount() for a future UI.
2026-06-27 firmware: move networking off the control loop — structural zero control-dropout (v0.6.0)
    Root cause of the v0.5.x multi-second loss-of-control: HTTP serving ran inside
    the single-threaded control loop (server.handleClient in telemetryUpdate), and a
    synchronous response write blocks on a marginal/dead WiFi link up to
    HTTP_MAX_SEND_WAIT (5 s) per chunk. /history backfill (10-16 chunks) under the
    app's aggressive retry stacked those into the 64-115 s stalls seen on the water;
    because failsafe runs after serving in the same loop, a stall disabled failsafe
    too and the PCA9685 latched cruise. (Not the WiFi scan — that's setup-only; not
    I2C — Wire is bounded. Confirmed against both mission l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
    [cmd.cpp, cmd.h, config.h, legend_cutter.ino, navigation.cpp, navigation.h, telemetry.cpp, telemetry.h]
2026-06-27 firmware: bench debug — log network-task stack high-water on each new low
    DEBUG_NET_STACK (default 1, bench-only): networkTask prints uxTaskGetStackHigh-
    WaterMark each time it hits a new minimum, so the worst-case headroom under the
    8192-byte stack — including a heavy /history backfill — is visible on the bench
    before range testing. Converges to silence; set 0 for water (harmless either way,
    USB-Serial is gone on the water). Confined to networkTask; loop() untouched,
    grep gate still holds. Compile-verified.
2026-06-27 firmware: serial console (r=reboot, s=status) — replaces the auto stack print
    The BOOT/EN button is sealed in the hull and serial-open auto-reset is flaky, so
    boot output is hard to catch and the per-new-low stack print was easy to miss.
    Replace it with a non-blocking serial console read in loop():
    - 'r' → ESP.restart() (reboot over serial, no hull button)
    - 's' → one status line: version, mode, uptime, heap, network-task stack
    high-water (worst-case free bytes) — on demand, no streaming
    Reads only buffered bytes (Serial.available/read), so it never blocks and doesn't
    touch the responsiveness guarantee. netTaskHandle captured so the loop can query
    the net task's stack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
    [config.h, legend_cutter.ino, telemetry.cpp, telemetry.h]
2026-06-27 firmware: depth near-field floor reads as no-echo, log raw echo µs (v0.6.1)
    Sonar pins to its ~0.88 m near-field floor when no bottom echo returns
    (every ping in the 06-27 estuary log; cf. clean 0.88-4.10 m trace in the
    06-05 pool log). Treat any reading below DEPTH_MIN_VALID_M as no-echo so
    the boat never reports a false-shallow depth. Add depth_raw_us to
    telemetry to distinguish timeout / floor-artifact / weak-echo next run.
2026-06-28 firmware: persist learned COG heading trim across power cycles (v0.6.2)
    cogTrimDeg (the GPS-COG vs compass residual) reset to 0 every boot, so the
    first AUTO of each run re-learned the fixed-boat heading bias from scratch
    (~20 s of wander). Now stored in the imu_cal NVS namespace alongside the mag
    cal it belongs to, seeded on boot, throttled-saved as it drifts, and zeroed
    by a fresh mag cal. First-AUTO tracking starts from the last run's trim.
    [config.h, imu.cpp]
2026-06-28 firmware: AUTO approach-heading lock + wider capture radius (v0.6.3)
    Stops the close-in waypoint circling: the steering setpoint was chasing
    the instantaneous bearing, which goes hypersensitive within a few metres
    of the point (GPS jitter swings it tens of degrees, so the boat hunts).
    - Approach lock: inside AUTO_APPROACH_LOCK_M (10 m) the setpoint latches
    to the bearing held on entry and stops tracking the instantaneous
    bearing. The boat drives a straight line through the zone; the existing
    perpendicular-crossing trigger captures.
    - CAPTURE_RADIUS_M 3 -> 5 m: 3 m was barely above the GPS noise floor, so
    the boat could orbit just outside it. Legs are ~65 m open water.
    - New telemetr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
    [config.h, legend_cutter.ino, navigation.cpp, navigation.h, telemetry.cpp]
2026-06-28 firmware: AUTO steering no longer dies on a slow control tick (v0.6.4)
    imuHeadingHoldUs() zeroed dt when a control-loop iteration exceeded 0.5 s,
    making maxDelta 0 and returning NEUTRAL_US — steering went dead for that
    tick and the boat drove straight/coasted with no heading correction. On
    0.5.x firmware, networking ran on the control loop, so a GET /history
    backfill could block the loop past 0.5 s and silently disable AUTO
    steering mid-leg (observed: boat arced 69 deg off the waypoint with the
    rudder pinned near neutral while the ESC kept driving).
    - Cap dt at 0.5 s instead of zeroing it, so a slow tick still allows a
    bounded slew step — steering keeps working.
    - Move the start-from-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
    [config.h, imu.cpp, imu.h, legend_cutter.ino]
2026-06-28 Revert "firmware: AUTO steering no longer dies on a slow control tick (v0.6.4)"
    This reverts commit 62aca3d77dc7a13375d2aff8655ea3546ceaa05b.
    [config.h, imu.cpp, imu.h, legend_cutter.ino]
2026-06-28 firmware: AUTO rudder slew float-accumulates — fixes neutral-pinned steering (v0.6.5)
    imuHeadingHoldUs() computed its per-tick slew step as (int)(85*dt+0.5). Once
    v0.6.0 moved networking off the control loop, the loop spins >170 Hz, so dt per
    call is <5.9 ms and that integer truncates to 0 every tick — the rudder was
    pinned at NEUTRAL for the whole AUTO leg while the ESC kept driving (confirmed:
    2026-06-28 v0.6.3 log, rudder_us==1500 in 97/97 AUTO samples vs 0.5.x logs where
    it tracked heading error and the boat closed on the waypoint). Latent since the
    v0.5.1 slew limiter; masked while networking-on-loop kept dt large.
    - Accumulate the rudder in a float; step by 85*dt with no integer t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
    [config.h, imu.cpp, imu.h, legend_cutter.ino]
2026-06-29 firmware: AUTO near-center damping via decoupled differential thrust (v0.6.6)
    The AUTO weave is a control limit cycle: the rudder's 5deg deadband zeroes the
    WHOLE PD output (incl. the kd damping term) at the target crossing, so nothing
    arrests the overshoot. Diff-thrust couldn't cover it because it was computed FROM
    the (deadbanded) rudder command — both effectors went dead near center. (Straight
    in MANUAL, weaving in AUTO at the same speed confirmed it's the controller, not
    the hull; the flat offline kd sweep is explained by D being disabled at the
    crossing.)
    Minimum fix — move the through-crossing damping to the motor channel, which has
    no linkage to fatigue, and leave the fragile rud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
    [config.h, imu.cpp, imu.h, legend_cutter.ino, motors.cpp, motors.h, telemetry.cpp]
2026-06-29 firmware: trim dead/duplicate telemetry fields (v0.6.7)
    - Drop batt_a everywhere (live + /history backfill): the INA219 shunt failed, so
    amperage reads a constant 0/-0. Bus voltage (batt_v) still good — kept.
    - Drop port_us: v0.6.6 added it but esc_us already IS the port motor
    (motorsPortUs()), so it was a duplicate column. esc_us (port) vs stbd_us (stbd)
    gives the AUTO diff-thrust split; revert the JSON capacity bump (2304->2048).
    Net field count back to the pre-v0.6.6 baseline plus stbd_us.
    [config.h, telemetry.cpp]
2026-06-29 telemetry: rename esc_us → port_us, keep stbd_us (v0.6.8)
    esc_us was the port motor under a stale name (singular ESC made sense only when
    both motors moved together; decoupled AUTO diff-thrust splits them). Use the
    clear pair port_us/stbd_us everywhere — no duplicate, no confusing alias.
    - firmware: live telemetry + /history backfill emit port_us (was esc_us).
    - app: TelemetryData type, Telemetry screen (Port/Stbd rows), flight-log
    throttle-up detection, history comment — all follow the rename.
    Capacity is comfortable: 2048-byte doc holds the full ~70-field set with ~30%
    headroom (v0.6.5 logs show every column populated, no overflow drops).
2026-07-01 firmware: multi-waypoint missions — /mission sequencer + telemetry (v0.7.0)
    Port the test_28 sequencer into legend_cutter's navigation module and marry it
    to the live crossing/approach-lock capture:
    - navigation now holds an ordered mission (route[MAX_WAYPOINTS], wpIdx,
    missionActive/missionComplete). Active-leg accessors keep their names so
    telemetry, the AUTO branch, and the app are unchanged. On capture the
    sequencer advances to the next leg (re-recording leg start); after the last
    leg it neutral-holds. A single waypoint is a 1-point mission.
    - POST /mission (top-level JSON array), POST /mission/clear, GET /mission.
    Per-leg (chained) fat-finger validation so a pre-planned rou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
2026-07-01 app: multi-waypoint PLAN mode + mission rendering (Map)
    - MapScreen gains a PLAN toggle. LIVE (default) is unchanged: tap = single
    waypoint, now gated behind a confirm when a multi-leg mission is running so a
    stray tap can't wipe the route.
    - Live mission renders as numbered markers styled by wp_idx (done/active/
    upcoming) + route polyline + the existing bright dashed active-leg line, with
    a LEG i/N HUD. GET /mission rehydrates the route on mount.
    - PLAN mode: tap water to add; tap a draft marker to select, then tap the map to
    move it or DELETE it (tap-to-select model — no drag, no reorder, most reliable
    in the WebView). Amber draft color vs cyan live. CONFIRM posts /mission an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
2026-07-01 firmware: fix multi-waypoint review findings (v0.7.1)
    From a review of v0.7.0:
    - navUpdate distance backstop no longer wipes the whole mission from any mode.
    It now runs AUTO-only and only for leg 0 (the one leg that can skip POST-time
    range validation, when a route is posted before the first fix). Mid-run legs
    were chain-validated at POST, so GPS jitter near a ~1 km leg — or the
    documented MANUAL 'steer closer to regain WiFi' detour — can no longer erase a
    validated, RAM-only route.
    - Restore the wp_set contract: navWpSet() stays true after the final capture
    (route loaded, running OR complete), matching the original single-waypoint
    behavior. This un-breaks consumers that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
    [config.h, navigation.cpp, navigation.h, telemetry.cpp]
2026-07-01 app: fix multi-waypoint Map review findings
    - Rehydrate race: GET /mission is authoritative; the single-waypoint telemetry
    fallback now runs only if GET failed, so the cached last frame can't collapse
    a multi-waypoint route to one point on relaunch. GET coords NaN-filtered.
    - Telemetry lags the local route by ~1 poll after CONFIRM; derive complete / leg
    index / marker 'done' styling from the local route, trusting telemetry's
    captured/wp_idx/wp_count only once wp_count matches (telemInSync). Fixes the
    brief false 'MISSION COMPLETE' / wrong LEG x/N on a fresh mission.
    - enterPlan preloads the WHOLE route once complete (re-run resends everything,
    not just the pinned final point).
    -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
2026-07-01 firmware: polish multi-waypoint residuals (v0.7.2)
    Low-severity, none operator-visible, from the follow-up review:
    - POST /mission requires numeric lat/lon (is<float>()), closing the gap where a
    JSON null/typo coerced to 0.0 and slipped through as an in-range (0,0) waypoint.
    - On leg advance, reset capBy so captured_by no longer reports the finished leg's
    trigger while driving the next one (telemetry honesty; nothing consumes it yet).
    - On leg advance, refresh wp_dist/wp_bearing to the new leg immediately so
    applyOutputs steers toward it that same control cycle instead of the just-passed
    point for one tick.
    [config.h, navigation.cpp, telemetry.cpp]
2026-07-01 firmware: address deeper multi-waypoint review (v0.7.3)
    - Over-range active leg now NEUTRAL-HOLDS instead of wiping the route, and
    applies to ALL legs (not just leg 0). Fixes the leg-0 backstop erasing a
    validated RAM-only mission on AUTO re-engage after a MANUAL detour, and gives
    later legs a runaway-hold for a sustained GPS glitch. Route is preserved;
    driving back in range (or GPS recovering) resumes it. AUTO branch gates on the
    new navActiveLegTooFar().
    - handleWaypoint now mirrors handleMission's numeric + bounds validation so the
    two set-paths don't drift (null still means clear).
    - /mission reject message is 1-based ('waypoint #N too far') to match the map
    markers; bad_le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
    [config.h, legend_cutter.ino, navigation.cpp, navigation.h, telemetry.cpp]
2026-07-01 app: address deeper multi-waypoint Map/log review
    - Same-count re-plan no longer trusts stale telemetry: expectReset blocks
    telemInSync until the boat reports leg 0 for the new mission, so re-entering
    PLAN in the post-CONFIRM window can't slice at a stale index and ship a
    truncated route (and no false 'MISSION COMPLETE').
    - Fallback hydrate is driven by missionFetch STATE, so a GET /mission failure
    re-runs it (a ref wouldn't) — the single waypoint renders on relaunch against
    firmware without GET /mission.
    - Graceful vs pre-0.7.0 firmware: hasMissionTelemetry gate keeps CAPTURED/marker
    completion working when wp_count/wp_idx are absent.
    - plantap branch guarded by inPlan (symmet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
2026-07-01 firmware: history ring carries waypoint identity for gapless mission playback (v0.7.4)
    The onboard history ring (WiFi-dropout backfill) stored boat position + waypoint
    distance but not WHICH leg or the waypoint coordinates, so a mission that ran
    partly through a dropout couldn't be reconstructed for multi-waypoint playback.
    Add wp_idx / wp_count / wp_lat / wp_lon to the compact record and emit them from
    GET /history under the same field names as live /telemetry, so backfilled rows
    drop into the same CSV columns. A multi-waypoint mission now plays back unbroken
    across a dropout — the telemetry is the proof artifact, so it has to be whole.
    Costs ~10 KB more RAM for the 1200-record ring (33%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
2026-07-01 firmware: document histlog DRAM ceiling (keep ring at 1200 / ~20 min)
    Tried bumping the history ring to 40 min — it overflows dram0 (the static ring
    shares that segment with the WiFi stack's working memory). ~1200 is the safe
    ceiling: larger values either fail the build (2400) or link but starve the heap
    and make WiFi flaky at runtime. Comment-only; capacity unchanged from v0.7.4.
    [config.h]
2026-07-02 app: multi-waypoint sync self-heals from the boat instead of latching
    Replace the expectReset/telemInSync/hydratedRef/missionFetch state machine
    with a single resyncMission() that asks GET /mission and trusts the boat's
    answer. The old latch waited for one specific telemetry frame (wp_idx==0)
    after a local change; a 1Hz poll could miss it entirely (WiFi drop right
    after CONFIRM, or an instant capture), freezing the LEG i/N display and,
    worse, letting a re-entered PLAN slice the route at a stale index and
    resend already-captured legs.
    - enterPlan now always fetches the boat's current mission before building
    the draft, so editing an in-progress route can never start from a stale
    guess abo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
2026-07-03 app: fix telemetry poll overlap and flapping disconnect flag
    - websocketService: self-chain the poll loop (schedule the next poll only
    after the current one settles) instead of a bare setInterval. TIMEOUT_MS
    (2000) was longer than POLL_MS (1000), so any poll slow enough to need
    its timeout let the next tick fire a second overlapping request — piling
    requests onto exactly the weak/lossy link that caused the slowness in
    the first place.
    - Debounce the disconnected flag to 2 consecutive failed polls. A single
    dropped poll at range used to flip _connected false immediately, which
    would make the Map screen's new NO LINK indicator flicker on brief blips
    instead of flagging real d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
2026-07-03 firmware: guard /telemetry against an unterminated overflow buffer (v0.7.5)
    serializeJson(doc, out) into the fixed char out[2048] can't overflow memory
    (ArduinoJson bounds-checks fixed-size array destinations), but if the payload
    ever filled the buffer exactly, there'd be no room left for a null terminator
    — and server.send() reads out[] as a C-string, so it would read past the
    buffer into whatever's on the stack next. Never observed (the existing WARN
    at 1800 bytes hasn't fired), but cheap to make impossible: hard-check the
    measured length against the buffer size and drop the frame with a 500 rather
    than ever hand server.send() a buffer that might not be terminated.
    [config.h, telemetry.cpp]
2026-07-03 firmware: runtime diff-thrust gain via /pid + AUTO safe-hold slew reset (v0.8.0)
    POST /pid now accepts optional diff_gain [0..2] alongside kp/kd; GET
    /telemetry reports it so app CSV rows are labeled with the active tuning
    values. RAM-only by design — reboot restores the flashed config.h
    defaults (boat never depends on the app). Boots at AUTO_DIFF_GAIN with
    DEFAULT_KP/KD unchanged: no behavior change until /pid is POSTed.
    Also: AUTO safe-hold now resets the rudder slew accumulator so resuming
    active steering slews from the parked rudder instead of snapping to a
    stale deflection.
    Supports the one-trip kd sweep for the AUTO heading limit cycle
    (D-dominated command saturating the 85 us/s ru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
    [cmd.h, config.h, legend_cutter.ino, motors.cpp, motors.h, telemetry.cpp]
2026-07-03 app: heading-hold kd preset buttons for the one-trip AUTO tuning sweep
    Replaces the disabled PID placeholder in SYSTEMS > SETTINGS with four
    preset buttons that POST {kp, kd, diff_gain} to /pid (v0.8.0+ firmware):
    2.0 TRY 1ST, 3.0 FIRMER, 1.2 SNAPPIER, 8.0 STOCK. kp fixed at 1.5; each
    preset pairs kd with a diff_gain holding kd*diff_gain ~= 2.0 so crossing
    damping stays constant and the sweep varies only the rudder D term.
    Active preset highlights from live telemetry (pid_kd + diff_gain), so it
    reflects what the boat is actually running and drops back to STOCK after
    a reboot. Values are RAM-only on the boat by design; the winner gets
    hardcoded into config.h. diff_gain flows into the flight-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
2026-07-03 viewer: record robust WebM with real bitrate so replays don't corrupt
    Safari's fragmented-mp4 MediaRecorder muxer corrupts under load (lost
    slices smear whole frames), and the browser's ~2 Mbps default starves the
    encoder on full-tab satellite imagery. Prefer WebM (VP9/VP8) and give the
    encoder resolution-scaled headroom (8-24 Mbps); mp4/h264 stays as the
    Safari-only fallback. fix-recording.sh still normalizes to a clean mp4.
2026-07-04 firmware: lock kd=2.0 / diff_gain=1.0 as AUTO heading defaults (v0.8.1)
    Water-validated 2026-07-04 (mission_logs/2026-07-04T10-43-26.csv): across
    13 legs / 442 steady tracking rows the old limit cycle is gone — 4 error
    sign-flips total in ~10 min (was 7 per 30 s), rudder inside 1500+-25 on
    100% of steady rows (range 1475-1523 vs 1411-1544 railing at kd=8), all
    waypoints captured, zero rudder snaps in AUTO. Gains confirmed 2.00/1.00
    for the whole run (single session, no reboot).
    Boat now boots on the winning tune with no app dependency; /pid presets
    remain available for future sweeps.
    [config.h]
2026-07-04 app: relabel kd presets after v0.8.1 default lock-in
    2.0/1.0 is now the flashed default (hint TRY 1ST -> DEFAULT); 8.0/0.25 is
    the pre-v0.8.1 tune, not stock (hint STOCK -> LEGACY). Values unchanged —
    all four presets stay as on-water fallbacks.
2026-07-07 firmware: defer deck-gun servo drive + slew-limit pan; audio reconnect (v0.8.2)
    Deck-gun pan no longer snaps to center at boot (weaponsBegin drives nothing;
    first drive is the first loop pass) and now slews toward its target instead of
    slamming — softer on the linkage and one less current spike on the shared rail
    while the DFPlayer is powering up. audioBegin() re-opens the UART and retries
    the handshake once, to catch a DFPlayer whose first handshake was lost to a
    power-on rail sag. No change to ESC/motor arming order.
    [audio.cpp, config.h, weapons.cpp]
2026-07-08 app: depth readout shows liveness + no-echo reason, not a bare --
    When the sonar pings but gets no clean bottom return (scattered water or
    below the ~1 m near-field floor), firmware omits depth_m but still sends
    depth_age_ms + depth_raw_us. The app was collapsing that to '--', which
    looks identical to the sonar being off.
    - Helm: DEPTH readout uses its already-reserved sub-caption slot (no
    layout change) to show reading age when valid, or 'no echo' when the
    sonar is actively pinging with no valid return.
    - Systems: status line proves liveness (changing age) and distinguishes a
    flat timeout (depth_raw_us==0) from a near-field artifact (>0), the
    exact diagnostic v0.6.1 added depth_raw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
2026-07-09 viewer: mode-colored track + mode/gap timeline + multi-CSV stitch
2026-07-11 app: contact/sync status on telemetry screen + 20-min flight-gone threshold
    P3: raise AUTO_GONE_THRESHOLD_MS 5min -> 20min so a foregrounded WiFi
    dropout (up to the boat's history ring depth) is bridged by /history
    backfill into ONE flight instead of finalizing + starting a new,
    un-backfilled flight. Crash-safety is the 30s draft checkpoint, unchanged.
    P1: read-only contact/sync banner on the Telemetry screen. Hidden while
    connected+caught up; shows time-since-last-frame when out of contact, then
    SYNCING / SYNC COMPLETE on reconnect. Adds a lastFrameAt() getter. Pure
    reads on a 1Hz tick - no effect on recording, backfill, or connection.
2026-07-11 firmware: v0.8.3 — persist WiFi assoc + RSSI in history ring (observability)
    Records the boat's WiFi link state on every history sample so a backfilled
    gap reveals which layer failed: assoc=0 means the boat left the hotspot (RF
    range / AP dormancy); assoc=1 means it stayed associated while only the app's
    socket died. RSSI rides through the gap too, so a gradual fade toward the
    noise floor (range) is distinguishable from a clean drop (dormancy/socket).
    - HistRecord: new HIST_F_WIFI_ASSOC (flag bit 5) + rssiDbm reusing the old
    _pad byte — zero added bytes/record, no change to the 1200x48B ring budget.
    - networkTask (core 0) publishes WiFi.status()/RSSI() ~2 Hz to volatile
    globals; his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
    [config.h, histlog.cpp, histlog.h, telemetry.cpp, telemetry.h]
2026-07-11 app: dead-socket recovery + poll failure-kind logging + keep-awake
    Reconnect robustness and observability, complementing the boat-side v0.8.3
    wifi_assoc/rssi instrumentation.
    websocketService:
    - Classify each poll failure: 'timeout' (AbortController fired, hung socket)
    vs 'neterror' (refused/reset — boat answered). Expose getLastFailureKind().
    - Dead-socket recovery: after STALL_LIMIT consecutive timeouts, force each
    poll onto a fresh TCP connection (unique URL + Connection: close) with a
    shorter timeout, until one succeeds. Targets the pooled half-dead connection
    the plain retry never escapes — the 'stuck for minutes then reconnects' case.
    - Clear the abort timer on every path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
2026-07-11 app: remove inert force-fresh-connection socket recovery
    A URLSession/CFNetwork ground-truth test (Node server logging accepted source
    ports; Swift probe replicating the poll loop with AbortController-style
    task.cancel()) showed the stack already closes an aborted poll's TCP
    connection and opens a new source port on the very next poll — with or without
    the workaround, and for both timeout- and cancel-based teardown. There is no
    surviving pooled 'zombie' connection to escape, so Connection:close + the
    ?_r cache-buster were inert (host:port pooling ignores the path/query anyway,
    and Connection is CFNetwork-reserved on iOS).
    Removes forceFreshConn / STALL_LIMIT / STALL_TIMEOUT_MS and the ?_r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
2026-07-11 app: log per-attempt poll outcomes across an outage (observability)
    Captures the app-side half of the reconnect layer question in the same
    diagnostic run as the boat's wifi_assoc, so a wifi_assoc=1 verdict (boat stayed
    associated) doesn't need a second run to see what the app's polls were doing.
    - websocketService buffers each failed poll of the current streak as
    {t, kind} (timeout = 2s abort, no response; neterror = fetch stack rejected —
    refused/reset/no-route, which RN can't split further). Reset at streak start,
    capped at 600, drained by the logger.
    - telemetryLogger stamps poll_trace on the reconnect frame: one token per
    failed poll, chronological, '<t|n>@<sec-since-first>'.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
2026-07-11 app: extend export schema guard to the saved-flight share path
    A completed diagnostic run is most likely exported from FlightDetail (SHARE
    CSV on a saved flight), not the live-buffer button — but that path shared the
    file with no column check. Factor the check into coreDiagnosticColumnsMissing()
    (the post-load-checkable fields: uptime/session_id + firmware-boundary
    wifi_assoc/rssi when v>=0.8.3) and run it in FlightDetail.onShare, with a
    confirm dialog so drift is acknowledged, not silent, and data is never lost
    (Share anyway). Live-buffer exportShare + finalizeAndSave keep the fuller
    check that also covers the reconnect columns at capture time.
    No behavior change.
2026-07-11 firmware: v0.8.4 — enlarge telemetry JSON buffers (prevent mid-mission blackout)
    handleTelemetry serializes into out[2048] and 500s if the payload exceeds it;
    with all 83 fields active (GPS + waypoint + mission + mag-cal) the margin can
    hit zero and live telemetry — the operator's only water-side surface — goes
    dark. The v0.8.3 wifi_assoc/rssi fields narrowed it further.
    - out[2048] -> static out[3072]: static because handlers run only on the single
    network task (non-reentrant), which also keeps 3 KB OFF the task stack — so
    the bigger buffer REDUCES NET_TASK_STACK pressure (verified: .bss +3072,
    stack frame shrinks). The 500 guard tracks sizeof(out) automatically.
    - StaticJson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
    [config.h, telemetry.cpp]
2026-07-11 app: collapse reconnect instrumentation to one count field; drop schema guard
    Lean rewrite of the diagnostic add — a smaller end state that deletes the buggy
    machinery rather than patching it (xhigh review found the trace/guard code could
    invert its own verdict). Net -150 lines.
    - Replace the per-attempt failureTrace / TRACE_MAX / reconnect_via with two
    counters (timeouts, neterrors) drained per gap. Counters reset after every
    successful poll, so a recovered blip can't leak onto a later gap, and t0 n0
    cleanly means 'app wasn't polling' with no AppState bookkeeping.
    - Dispatch listeners OUTSIDE the try and isolate each, so a throwing subscriber
    can't be misread as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
2026-07-11 firmware: v0.8.5 — guard doc.overflowed() on /telemetry and /mission
    The real silent-truncation path. ArduinoJson 7.4.3 is heap-elastic (the
    StaticJsonDocument<N> template arg is a vestigial capacity() shim), so the pool
    is grown on the heap and a failed allocation drops members WITHOUT any error:
    ints/bools survive inline while snprintf'd string values need a pool copy and go
    null. gps_fix stays true while lat/lon/heading go null.
    measureJson() then reports the TRUNCATED length, which passes the out[] size
    guard — so the boat ships a 200 OK with fields missing and the app records blank
    rows while believing it is connected. A size guard structurally cannot catch
    this: truncation makes t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
    [config.h, telemetry.cpp]
2026-07-11 app: fix NO CONTACT timer resetting on app foreground
    The Telemetry "time since contact lost" banner (1a02591e) anchored its
    timer to lastFrameAt() -> autoLastFrameAt, a variable that was ALSO
    bumped to now on foreground-while-recording (onAppStateChange) for the
    boat-gone detector's benefit. So each time the operator reopened the app
    onto the Telemetry screen with the boat out of contact, the timer reset
    to 0:00 instead of showing true elapsed since disconnect.
    Split the anchors: autoLastFrameAt is now written only by real frames
    (the display reads it, so it survives foreground + in-app navigation);
    add autoForegroundedAt for the foreground grace, and have autoTick judge
    silence against ma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
2026-07-11 app: show backfill sync progress (rows received of ~total)
    The reconnect banner showed a bare "SYNCING…" with no sense of motion, so
    the operator couldn't tell whether backfill was advancing or stuck before
    proceeding with the mission.
    Report page-level progress without touching the atomic merge/cursor path:
    - fetchHistorySince gains an optional onPage(receivedSoFar) callback, fired
    after each page is confirmed received. Display-only; the return shape and
    the caller's watermark advance are unchanged.
    - The pump resets a module-level syncSynced to 0 at the start of each gap
    attempt and feeds it from onPage (clamped ≤ the estimated total). A failed
    attempt refetches from g.sinceMs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
2026-07-11 firmware: v0.9.0 — uniform-rate history with one-time >20min coarsening
    Keep the whole telemetry-history recording at a single uniform interval: a
    dropout of <=20 min stays entirely at 1 s (unchanged common case); if the app
    has been gone strictly longer than 20 min, the ring coarsens ONCE — it
    retroactively thins stored data to 2 s and continues at 2 s — so 1200 records
    now span ~40 min instead of ~20, with no RAM growth, no record change, and no
    replay/export change. (HISTLOG_COARSE_MS=3000 gives ~60 min at 3 s.)
    Mechanism:
    - Capture cadence is a variable intervalMs (fine 1 s -> coarse 2 s).
    - Trigger: core-0 handlers bump lastClientMs; histlog (core 1) coarsens when
    now-lastClien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
2026-07-12 app: fix telemetry drift-loss and live/backfill seam duplicate
    Two app-side data-completeness fixes found in bench testing.
    Defect 2 — single seconds lost on a healthy link. The poll re-chained
    setTimeout(poll, POLL_MS) AFTER the awaited fetch completed, so the period was
    1000ms + RTT and aliased the boat's 1 Hz telemetry — ~1 boat-second dropped
    every ~13 s (~7% at RTT ~75ms), below the 3 s gap trigger so never backfilled.
    Fix (websocketService): re-chain on a fixed wall-clock cadence,
    max(0, POLL_MS - elapsed), so polls start ~1000ms apart regardless of RTT.
    Defect 1 — duplicate row at the live/backfill seam. Dedup lived only in
    mergeBackfill; the live-append path pushed with none.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
2026-07-12 app: stamp freeze start-time into js_freeze for probe cross-correlation
    The JS-thread heartbeat (landed in f268f757 alongside D's cadence fix, but
    authored here) reported a freeze's magnitude, AppState-going-in and busy tag,
    but not WHEN it started. A freeze that predates a flight's first row — the
    right-after-connect symptom we are specifically hunting — lands on row 0 with
    no way to place it in time, which defeats cross-correlation against the Mac
    probe's absolute timeline. Stamp the freeze's start instant (now minus the
    measured lateness) into the js_freeze field.
    Observability only; no behavior change.
2026-07-13 app: throttle reconnect churn that jams the boat (backoff + gate backfill)
    Root cause (see RECONNECT_STALL_REPORT.md): the boat's WebServer serves one client
    at a time and holds a connection ~5s (HTTP_MAX_DATA_WAIT) waiting for a complete
    request. On a link too weak to deliver a poll's abort teardown, each abandoned
    connection becomes a half-open orphan the boat holds for 5s. The app opened a new
    connection every ~1-2s (no backoff) plus retried /history backfill every 5s during
    the outage -- orphans accrued faster than the boat shed them and it stopped
    answering everyone until the churn stopped. Explains the founding symptom: the
    stall tracked disconnect DURATION, not distance.
    6.1 websocke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
2026-07-13 docs: Task A handoff + committed reconnect-stall report (provisionally closed)
    Project going on hiatus ~2 weeks (boat 4S pack over-discharged/scrapped; battery
    swap needs cutting the hull). Task A provisionally closed: multi-minute lockout root
    cause reproduced, fix committed (be07515d), one field confirmation outstanding.
    - docs/TASK_A_OPEN_ITEMS.md: pickup point for whoever resumes. Root cause (backlog +
    marginal link -> pumpBackfills churn jams the single-client server for everyone;
    unfixed 36-39% locked out, fixed 83%, good-link control drains 2s), the fix (6.2
    gate is the loop-breaker; 6.1 backoff secondary; nconsec3 not adopted), the ONE
    outstanding test (field excursion with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
2026-07-14 fw: passive low-voltage alarm (annunciation only) v0.10.0
    Latching alarm on the INA219 bus rail — never touches ESCs, rudder, nav
    state, or mode. Trigger: 6.0V < batt_v < 13.2V sustained 30s (window's
    lower bound suppresses bench/USB, where the HV bus reads ~0V; the sustain
    rejects motor-load sag). Clears only on >13.2V sustained 30s; once latched
    a dip below 6.0V keeps annunciating. RAM latch — power cycle clears it.
    Annunciation while latched:
    - horn every 10s, serviced on the core-0 network task so the DF UART stays
    single-core and audioPlay's pause+50ms never blocks the control loop;
    runs unconditionally (no client/association gate) for the app-closed case.
    - nav-light double-bl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
    [battery.cpp, battery.h, cmd.h, config.h, legend_cutter.ino, lowvolt.cpp, lowvolt.h, telemetry.cpp]
2026-07-15 move stall report to docs
2026-07-17 site: de-slop copy — plainer first-person voice, drop numbering, tighten headers
2026-07-18 firmware v0.11.0: bilge burst/cooldown pump cycle + pump-run nav flash
    Rework the auto bilge pump from a 60 s-then-give-up duty cycle into
    burst-then-rest that never gives up: run BILGE_BURST_CYCLES (3) pulses of
    6 s on / 6 s off, then a BILGE_COOLDOWN_MS (60 s) rest, and repeat while the
    rear probe stays wet. A full bilge is the normal steady state on this hull
    (the pump can only draw down to just below the probe), so the old stuck-latch
    "give up" was wrong; it's removed. The burst is committed once started so a
    probe flicker won't stop it (primes the pump, lets water settle) — rear is
    re-checked only at each cooldown boundary. Manual is unchanged (cycles forever).
    Add a triple-blink nav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
    [bilge.cpp, bilge.h, config.h, legend_cutter.ino, telemetry.cpp]
2026-07-18 docs: close Task A — reconnect stall field-confirmed on fixed build
    Field excursion 2026-07-18 on the fixed build (be07515d) through the real
    phone/hotspot stack. Two runs:
    - Void first attempt (15:12 CSV): phone backgrounded, iOS suspended the JS
    engine for the whole ~24.6-min gap (js_freeze late=1477600). A suspended app
    generates no churn, so a clean reconnect proves nothing. Re-run rule: Auto-Lock
    Never, app foreground, screen on; validate reconnect-row js_freeze is small.
    - Valid pass (19:17 CSV): app awake throughout. Real 9.3-min out-of-range
    excursion (reconnect marker t39 n23 — neterrors = genuinely out of range, not a
    jam). No multi-minute lockout, session_id stable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
2026-07-19 firmware v0.12.0: flood alarm on fwd/mid probes → nav strobe
    New floodalarm module: latches a fast 5 Hz nav-LED strobe when the
    forward OR mid bilge probe reads wet, annunciating a pooling-forward
    flood to an operator out of app range. The fwd/mid probes were
    telemetry-only until now; the rear probe + pump logic are untouched.
    - Asymmetric debounce: FLOOD_TRIGGER_SUSTAIN_MS=1500 (quick, rejects
    probe chatter — provisional pending field obs of chop), FLOOD_
    CLEAR_SUSTAIN_MS=30000 (slow, so one wave sloshing a probe dry can't
    silence a real flood). Auto-clears; power cycle also clears the latch.
    - Shared nav LED priority: low-volt > flood > pump-run > steady nav.
    Flood self-gates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
2026-07-21 firmware v0.13.0: full-mission flash log (flightlog) — LittleFS file per boot, /flights retrieval, /history deep-serve
2026-07-21 app: flightlog import flow — /flights recovery UI, verified import + boat-side delete, persisted session anchors
2026-07-25 firmware v0.13.2: /history ring reads resolve against one window snapshot
    histlogAt() re-derived the ring window (oldest = head + CAPACITY - count) on
    every call, while the control loop advances head once a second. Once the ring
    is full the window advances with it, so a paged /history read walking absolute
    indices had the window shift under it and skipped exactly one record per
    append — measured as 3 lost records in a 6.1 s, 15-page backfill at 25 min
    uptime, with zero duplicates (the uptimeMs > since filter can only lose, never
    repeat). Affects backfills of dropouts long enough to fill the ring; the flash
    flightlog served the same span byte-perfect, which is how it surfaced.
    Replace hist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
    [config.h, histlog.cpp, histlog.h, telemetry.cpp]
2026-07-25 firmware v0.13.2: /flights caps by file number, not iterator arrival order
    flightlogList() stopped reading at FLIGHTLOG_MAX_FILES and only then sorted, so
    past 24 stored files the surviving set was whatever the littlefs directory
    iterator happened to yield first — and the active file could be missing from
    its own inventory, which the app's import flow keys off. The boot prune floor
    does not bound this: a 0-record file is 64 B, so hundreds can accumulate before
    300 KB free is threatened.
    Scan every file and keep the highest numbers (newest missions, always including
    the active file) via an insert-and-evict into the ascending window; files older
    than everything kept skip the header read ent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
    [flightlog.cpp]
2026-07-26 firmware v0.13.3: reject out-of-range GPS course at the source
    TinyGPS++ skips empty NMEA terms, so an RMC carrying no track angle leaves
    course holding its last parse while isValid() stays true. Observed on the
    2026-07-25 bench boot: course latched 250726 — the ddmmyy date — for all 175
    records of that boot, then read a normal 8.6 on the next boot. Intermittent and
    per-boot, not permanent.
    Consequences it reaches: imuUpdateCogTrim() feeds gpsCourseDeg() into the
    persisted heading trim, and 250726 mod 360 = 166 deg against a ~234 deg heading
    drives cogTrimDeg to its -30 deg clamp in ~9 s and saves that to NVS. The bench
    guards (>=1 kt, forward thrust) held it off here; both are satisfie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
    [config.h, gps.cpp]
2026-07-26 firmware v0.13.4: coarsening thins the RAM ring only, flash keeps 1 Hz
    flightlogPush() sat inside histlogUpdate() after the interval gate, so when the
    ring coarsened to 2 s (no polling client for >20 min) the flash log coarsened
    with it. Measured on m11 2026-07-25: 1 s until uptime 3280 s, then 553 records
    at 2 s for the last 18.2 min — ~540 samples never captured. That is exactly the
    long-unattended mission the flight log exists to capture at full resolution, and
    the ring's 58 KB budget is not a constraint flash shares (1.1 MB free).
    Capture now always runs at HISTLOG_INTERVAL_MS and every record goes to flash;
    the ring stores one of every ringStride captures instead of slowing capture.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
2026-07-26 firmware v0.13.5: record fwd/mid bilge probes in the flight log
    The forward and mid probes drive the flood alarm but were live-telemetry
    only, so a mission flown out of WiFi range could not say where water
    reached. They now ride the two unused bits of the HistRecord flags byte
    and are emitted by /history, so backfilled and imported rows carry the
    same bilge_fwd/bilge_mid columns as live rows.
    Record stays 48 bytes: no flash format change, no added storage, and
    files recorded before this read both bits clear (dry).
2026-07-26 app: wire EAS Update so JS-only changes ship without a rebuild
    Adds expo-updates with a fingerprint runtime version, so a bundle is only
    served to native builds it is actually compatible with. Checks on launch
    but never blocks it (fallbackToCacheTimeout 0) — the phone is often
    hosting the boat's hotspot with no route to the internet, and a launch
    that stalls waiting on an update server is a launch that fails at the
    ramp. Downloads in the background, applies on the next launch.
    Production builds subscribe to the 'production' channel. Requires one
    full build to install the runtime; pushes are free after that.
2026-07-26 app: track package-lock.json so EAS builds are reproducible
    The lockfile was gitignored, and EAS uploads only git-tracked files. That
    broke the build two ways: the fingerprint runtime version was computed
    over a project WITH a lockfile locally and WITHOUT one on the builder, so
    the hashes could never agree; and more seriously, the builder resolved
    dependency ranges from scratch, so a published build need not contain the
    same dependency versions tested against the boat.
2026-07-26 app: ignore dist/, the eas update export directory
    eas update writes the exported bundle to app/dist/, which left the tree
    dirty and got the published update tagged with a '*' commit — implying the
    bundle did not match the named commit when it did.
2026-08-01 firmware v0.13.6: boot prune bails on a failed remove instead of looping
    pruneToFloor ignored LittleFS.remove()'s result; a persistent failure
    (corrupt FS below the free floor) would rescan the same file forever and
    hang setup() — boat dead at power-on, no RC, no failsafe. Now a failed
    remove breaks out and boot continues; a genuinely full partition is
    already handled by the logFull write path.
    [config.h, flightlog.cpp]
2026-08-01 app: a page-capped backfill keeps its gap queued instead of leaving a hole
    Deep-serve (firmware 0.13.0) pages /history from flash back to boot, so a
    long gap can exhaust BACKFILL_MAX_PAGES with the boat still holding more —
    previously pumpBackfills shifted the gap as filled and the flight kept a
    silent hole. pageSince now reports capped; the pump advances the gap's
    cursor and keeps pulling, and the flash-log import refuses a capped pull
    so it can never save-and-delete a prefix of a mission.
2026-08-01 firmware v0.13.7: flightlog health in /telemetry; failed open retries instead of latching
    Mission logging dying mid-run was invisible in the water: logFull's only
    signals were a Serial line and /flights fields the app never rendered.
    /telemetry now carries flight_log (active file, "" = disabled),
    flight_full, flight_dropped, and flight_free_kb — free space is a
    per-commit snapshot so the 1 Hz poll never pays a filesystem traversal.
    A failed append-open no longer latches logFull; it retries each commit
    cadence (queue buffers meanwhile, overflow shows in flight_dropped), so
    only a genuine out-of-space write failure stops the log.
    [config.h, flightlog.cpp, flightlog.h, telemetry.cpp]
2026-08-02 firmware v0.14.0: latched bilge-probe views — 2.5 s latch, hit counter, contact duty% on all three probes
    A marginal (filmed) probe can read low for less than a loop pass: the pump FSM
    catches it, a 1 Hz sampler never does (8/2 mission: 12 wet-triggered bursts,
    zero wet samples in 993). Telemetry and the flight log now consume latched
    views; pump FSM and flood alarm keep the raw reads unchanged.
    - bilge: 2.5 s stretch latch + hits (latch rising edges) + duty (% of loop
    reads low per second, contact quality) per probe; probe statics volatile
    per cross-core convention
    - /telemetry: bilge_* now latched; new bilge_*_hits, bilge_*_duty
    - flight log: fwd/mid flag bits capture latched (no sh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
2026-08-02 app: bilge rows show latched wet with contact duty% and hit count
    WET rows carry the duty% (probe health: ~100 clean, single digits = film —
    clean contacts before the next run); hits make a straddled blip evident from
    the count moving. Fields are optional, so the screen renders unchanged
    against pre-v0.14.0 firmware.
2026-08-02 logs: 8/2 mission m27 (CSV + flash flight log) and rear-probe bench session evidence
    [2026-08-02T10-22-12.csv]
